Wexito11/Force-1-Hardato/README.md

# Форс-1 - робот-путеобходчик

Проект команды на Всероссийские соревнования по робототехнике «Хардатон «Инженерный вызов» 2026» (МГТУ им. Н.Э. Баумана).

Тема: «Разработка робототехнических систем для автономной инспекции и обслуживания протяжённой критической инфраструктуры». Направление - железная дорога.

## Идея

Автономный робот едет по рельсам и проверяет путь: ширину колеи, перекос, износ головки рельса, стыки и шпалы. Робот состоит из двух модулей - каждый едет по своему рельсу - и двух телескопов между ними. Телескоп одновременно служит измерителем ширины колеи.

Режим укрытия: когда идёт поезд, робот сжимает телескопы, ложится на шпалы между рельсами, пропускает поезд над собой и снимает его ходовую часть снизу. Потом поднимается и возвращается на рельсы.

Обслуживание: маркировка найденных дефектов, уборка металлического мусора электромагнитом, подтяжка ослабших болтов (проба на финале), концепт сварочной головки.

Масштаб прототипа 1:2: колея 760 мм (решение 08.11; версия 1:8 - запасная).

## Сроки

| Этап | Даты |
|---|---|
| Заочный этап (паспорт, 3D-модель, схема) | 02.11 - 08.11.2026, цель - всё готово к 06.11 |
| Финал (прототип и защита) | 27.11 - 01.12.2026, Роботоцентр МГТУ |

## Структура репозитория

| Папка | Что внутри | Ответственный |
|---|---|---|
| `docs/` | ТЗ и габариты, концепция, план работ, паспорт | вся команда |
| `cad/` | STEP, STL, DXF, рендеры 1:2, чертежи PDF, `tools/` - исходники генератора и рендерер | Участник 1 (модули), Участник 2 (телескоп, сборка) |
| `electronics/` | принципиальная схема, распиновка, таблица компонентов .xls | Участник 3 |
| `firmware/esp32_a/` | прошивка модуля A: мотор, полозья, ремонт, TOF, HC-SR04 - заготовка | финал |
| `firmware/esp32_b/` | прошивка модуля B: мотор, полозья, телескоп, AS5600, RFID - заготовка | финал |
| `firmware/rpi/` | `force1.py` - состояния S0-S11, отчёт, веб-панель; `rail_vision.py` - камера (в track/) | финал |
| `track/test-rail-1k2/` | тест-рейка 1:2 с дефектами: чертёж, DXF, rail_vision.py | Участник 4 |
| `edu/` | «Форс-1 Junior» - учебная версия и инструкция для школьников | Участник 4 |

## Правила

- Каждый работает в своей папке.
- Коммит в конце каждого дня с понятным сообщением: что сделано.
- Исходники CAD тяжёлые - храним на общем диске, в git кладём экспорт (STEP, PDF, PNG).
- Перед началом CAD сверяться с `docs/tz-gabarity.md`. Если число меняется - сначала правим этот файл и пишем в чат команды.

## Документы

- [ТЗ и габариты](docs/tz-gabarity.md)
- [Концепция (PDF)](docs/concept.pdf)
- [План работ (PDF)](docs/plan.pdf)
- [Общий контекст для агентов](docs/context.md)
- [Промпты для агентов](docs/agent-prompts.md)
- [Сверка перед сдачей](docs/sverka-sdacha.md)
- [Как собрать (финал)](docs/sborka.md)
- [Карта проекта: что где лежит](docs/karta-proekta.md)
- [Защита на финале: 5 минут](docs/zashchita.md)
- [Протокол Pi ↔ ESP32](firmware/PROTOCOL.md)
