Wexito11/Force-1-Hardato/electronics/README.md

# Электроника

Участник 3: принципиальная схема (силовые цепи толстыми линиями, сигнальные тонкими), распиновка ESP32 A, ESP32 B и Raspberry Pi 5, расчёт питания, таблица компонентов .xls.
