Wexito11/Force-1-Hardato/cad/README.md

# CAD

Экспорт STEP, рендеры (PNG, светлый фон) и чертежи деталей (PDF). Исходники CAD - на общем диске.

- Участник 1: модули A и B, колёса, полозья.
- Участник 2: телескоп и привод, общая сборка, рендеры, чертежи под лазер (раскладка 500×300, ≤ 3200 см² на материал).
