Wexito11/Force-1-Hardato/edu/README.md

# Форс-1 Junior

Учебная версия для школьников 7-11 классов: тележка на одном рельсе (Arduino Nano, JGA25-370, L298N, HW-511 считает шпалы, HC-SR04 - стоп перед препятствием, пищалка - сигнал дефекта). Инструкция: 5-6 шагов сборки, 2 урока по 45 минут, готовый скетч.
