Wexito11/Force-1-Hardato/firmware/esp32_a/README.md

# ESP32 A (модуль A)

Мотор + энкодер, 2 × MG996R полозьев, TOF250, HC-SR04 (TRIG IO12, ECHO IO36 через делитель), ремонтный модуль. Плата ESP32-ETH01. Связь с Raspberry Pi по UART2 (GPIO4/5), прошивка с Pi через EN/IO0 (GPIO17/27) или PL2303HX. Пишем на финале.
