Wexito11/Force-1-Hardato/firmware/esp32_b/README.md

# ESP32 B (модуль B)

Мотор + энкодер, 2 × MG996R полозьев, NEMA17 телескопа, AS5600 (ширина колеи), RFID, TOF250. Связь с Raspberry Pi по UART через телескоп. Пишем на финале.
