Wexito11/Force-1-Hardato/firmware/rpi/README.md

# Raspberry Pi 5

Камера (дефекты, осмотр поезда снизу), RPLIDAR C1, MPU-9250, логика инспекции и режима укрытия, веб-панель оператора по Wi-Fi.
