Wexito11/Force-1-Hardato/docs/tz-gabarity.md

# ТЗ и габариты

Черновик. Числа обсуждаем и фиксируем на созвоне во вторник 03.11. Пока этот файл не утверждён, CAD не начинаем.

## Габариты

| Параметр | Значение | Примечание |
|---|---|---|
| Масштаб / колея | ~1:8 / 190 мм | между внутренними гранями головок |
| Рельс демо-пути | головка ~12 мм, высота ~40 мм | фанера, склейка полос |
| Шпалы | 31 мм, шаг 68 мм | фанера с лазера |
| Модуль | 160 × 85 мм, высота корпуса ≤ 60 мм | колесо у внешнего края, корпус внутрь колеи; 2 этажа: фанера 6 мм + оргстекло 3 мм |
| Колесо | Ø50, реборда 5 мм, конус 1:20 | 3D-печать, ширина ~20 мм |
| Зазор между модулями на рельсах | ~30 мм | |
| Ход телескопа | ~35 мм | проверить в скелете CAD |
| «Дно вагона» на демо | лежащий робот + 20 мм | задаёт высоту доски-«поезда» |

## Что измеряем и как

| Параметр | Датчик, где стоит | Норма → дефект (демо) |
|---|---|---|
| Ширина колеи | AS5600 на шкиве телескопа, модуль B | 190 мм → отклонение > 2 мм |
| Перекос | MPU-9250, модуль A | 0° → крен > 0,8° |
| Износ головки | TOF250 вниз, по одному на модуль | эталон d0 → d - d0 > 2 мм (проверить точность датчика) |
| Стык | TOF250 + энкодер | провал > 3 мм длиной < 10 мм |
| Шпалы | HW-511 вниз, внутренняя сторона модуля | шаг 68 мм → отклонение > 10 мм или пропуск |
| Препятствие | RPLIDAR C1, модуль A, спереди | объект ближе 30 см → стоп |
| Координата | энкодер LM393 + RFID-метки | пикет каждые ~0,5 м |

## Компоновка

**Модуль A (ведущий):** Raspberry Pi 5, камера на MG90S, RPLIDAR C1, MPU-9250, ESP32 №1, L298N, мотор JGA25-370 + энкодер, TOF250, HW-511, 2 × MG996R, ремонтный модуль, зажим ремня.

**Модуль B (силовой):** держатель 4×18650, XH-M400 × 2, LM2596, тумблер, ESP32 №2, L298N, мотор + энкодер, NEMA17 + A4988 + шкив + AS5600, RFID, TOF250, 2 × MG996R.

Тяжёлое (батарея, моторы) - на нижний этаж. Размеры плат перед CAD берём из даташитов или замеряем.

## Питание

- 12 В (XH-M400) - моторы, NEMA17.
- 6 В (XH-M400) - сервоприводы. Полозья поднимать по очереди, чтобы снизить пиковый ток.
- 5,1 В - Raspberry Pi 5 (нужно 5 В 5 А): отдельный преобразователь, LM2596 не хватит.
- 5 В (LM2596) - ESP32 и датчики.
- Через телескоп в модуль A: 12 В, 6 В, 5 В, GND, UART.

## Вопросы организаторам

- [ ] Можно ли второй ESP32 (например, ESP32-C3-MINI из Приложения 2)?
- [ ] Модель Raspberry Pi в наборе и чем его питать?
- [ ] Выдаются ли аккумуляторы 18650?
- [ ] Есть ли пружины или резинки для телескопа?
- [ ] Материалы на демо-путь - из лимита команды или общие?
- [ ] Помпа и VL53L0X из Приложения 2 - можно ли?
- [ ] Какое передаточное число у JGA25-370 в наборе?
