Wexito11/Force-1-Hardato/track/README.md

# Демо-путь

Участник 4: рельсы и шпалы из фанеры, участки с дефектами (расширение колеи, перекос, зазор в стыке, пропуск шпалы, ослабший болт), доска-«вагон» на стойках.
