Wexito11/Force-1-Hardato/docs/context.md

# Контекст проекта «Форс-1» (Хардатон «Инженерный вызов» 2026)

Этот файл - общий контекст для всех чатов и агентов проекта. Читать первым. Если решение меняется - править здесь.

## Соревнование

- Организатор: Центр молодёжной робототехники МГТУ им. Н.Э. Баумана. Документы: «Регламент_Хардатон_2026.pdf», «Задание заочного этапа.pdf» (лежат в проекте).
- Тема: «Разработка робототехнических систем для автономной инспекции и обслуживания протяжённой критической инфраструктуры».
- Заочный этап: 02.11 - 08.11.2026, сдача до 08.11 23:59 МСК. Цель команды - всё готово к пятнице 06.11, отправка в субботу 07.11.
- Сдаём: паспорт проекта (PDF по шаблону), 3D-модель (3 изображения с разных ракурсов), электрическую принципиальную схему (силовые цепи толстыми линиями), чертежи деталей под ЧПУ в натуральную величину внутри прямоугольника 500×300 мм, таблицу компонентов .xls. Рендеры, схема и чертежи - одним PDF, всё в одной папке на диске, ссылка в паспорте.
- В финал проходят не более 10 команд. Финал: 27.11 - 01.12, очно, собрать рабочий прототип и защитить за 5 минут.
- Оценка заочного этапа (100 баллов): анализ аналогов 15, актуальность и новизна 14, соответствие теме 10, креативность 10, ГОСТ 7, развитие 7, качество 3D-сборки 10, графическая документация 10, электросхема 7, оптимальность 5, технологичность 5.

## Жёсткие ограничения

- В прототипе только компоненты и материалы организатора: базовый набор (Приложение 1 регламента), специальные (Приложение 2) - только по согласованию. Свои компоненты = дисквалификация. Свои - только ноутбуки и ПО.
- Листовые материалы (оргстекло 3/4 мм, фанера 3/4/6/10 мм): лазер 500×300 мм, не более 3200 см² каждого. Трубы алюминиевые Ø12/Ø10/Ø8/Ø6 ×1 мм - по 0,5 м. Профили Т, П, прямоугольный, Г - по 1 м. 3D-печать: поле 201×201×210 мм, не более 800 г с поддержками. Крепёж М3/М4, стойки, ремень GT2 1 м, шкивы Ø15, муфты 4 шт., колёса внедорожные 4 шт.
- Прототип должен быть безопасным (никакой настоящей сварки, огня и т.п.).

## Масштаб: 1:2 (решение 08.11)
Команда перешла с 1:8 на 1:2: в 1:8 робот в укрытии должен быть ниже 21 мм, это невозможно. Правило «правильно» (уточнено 09.11 по ГОСТ 9238): самые низкие части поезда - необрессоренные части тележек - не ниже 65 мм над УГР (новые конструкции - 80), ниже только гребни колёс. В 1:2: УГР 100 над шпалой, низ частей поезда 132,5, зона укрытия - высота ≤ 117 (запас 15) и |Y| ≤ 345 (внутри внутренних граней колёс поезда, запас 15). Путь 1:2 к Р65: колея 760 (по внутренним граням головок), головка 37,5, шаг шпал 272. Главный документ - «Масштаб 1:2 - решения», эталон файлов - `Хардатон\Участник 1\1к2`. Всё, что про колею 190 / трубы Ø10 / пружины-арки - устарело.

## Концепция
- Два модуля A (ведущий) и B (силовой), каждый на своём рельсе. Корпус 300 × 120 × 66, фанера 4 (шип-паз), крышка оргстекло 3. Колесо у внешнего края, корпус внутрь колеи.
- Колёса: по 2 на модуль - ведущее JGA25-370 при +X, холостое на M4. Обод Ø50 × 40, реборда Ø66 (с внутренней стороны), ширина 45, конус 1:20, база 240. 3D-печать.
- Телескоп: 2 направляющие (X = ±90, Z = 44) - П-профиль 20×20 L 440 в A, прямоугольный 15×10 L 440 в B на печатных вкладышах. Привод: Г-профиль 20×20 L 632 закреплён в A, на нём ремень GT2 зубьями наружу; в B NEMA17 вертикально, шкив Ø15 + прижимной ролик. Ход 80 на модуль (общий 160, зазор 502 → 342). Пружин нет: реборды прижимаются мотором с ограничением тока A4988, колею меряет AS5600 №1 на шкиве.
- Полозья: на модуль 2 × MG996R снаружи торцов, звенья 60, стойки 72,5, подошва фанера 6 (2 × 395 × 12). Поднят +50,8°, опущен -42,5° (колёса на 10 над рельсом). Момент ≤ 4,8 кг·см при массе ~3,2 кг.
- Режим укрытия: полозья вниз (A, потом B) → телескоп сжат → полозья вверх → робот лежит на шпалах (низ 12, крышка 81, лидар 113 над шпалой; части поезда не ниже 132,5), поезд проходит сверху, камера на MG90S снимает ходовую часть → обратно. Сигнал: команда по Wi-Fi или вибрация рельса (MPU-9250).

## Инспекция (пороги 1:2)
| Параметр | Датчик | Дефект |
|---|---|---|
| Ширина колеи | AS5600 №1 на шкиве телескопа | > 8 мм от 760 |
| Перекос | MPU-9250 (A) | крен > 0,8° |
| Износ головки | TOF250 вниз на каждом модуле | d - d0 > 8 мм |
| Стык | TOF250 + энкодер, камера (болты) | провал > 12 мм |
| Шпалы | HC-SR04 вниз через дно, по одному на модуль (HW-511 не достаёт) | 272 ± 40 или пропуск |
| Препятствие | RPLIDAR C1 на крышке A спереди (X 95,5), утоплен в вырез Ø58, площадка на стойках M3 на 58 от низа корпуса; верх 101 от низа корпуса, в укрытии 113 < 117 | ближе 30 см → стоп |
| Координата | энкодер LM393 + RFID RC522 (метки на внешней грани головки); запас - счёт шпал | пикеты |

Оператор: веб-страница на Raspberry Pi 5 - график колеи и список дефектов «тип + координата + фото». Состояния S0-S11 - в документе «Демо-путь и ремонт».

## Обслуживание (ремонт)
- В прототип: маркировка каплей краски (помпа из Прил. 2 + LR7843 №1; запас - магазин фишек на MG90S), уборка металлического мусора (электромагнит BR-P25/11 на рычаге MG90S + LR7843 №2, ШИМ ≤ 70 %).
- Проба на финале: гайковёрт - JGA25-370 №3 (лучше JGA 77 об/мин из Прил. 2), печатная головка под ключ 7 на пружине, рычаг MG90S, стоп по AS5600 №2 + концевик. Для М4 в фанере момента хватает (~0,25 Н·м), для реального пути - нет («развитие»).
- Только концепт в CAD: сварка/наплавка стыков.

## Электроника
- Модуль A: Raspberry Pi 5 (вертикально на наружной стенке), камера Pi на MG90S под крышкой, RPLIDAR C1 на крышке A спереди, утоплен в вырез Ø58 (луч ~177 над шпалой на рельсах = 77 над головкой, обзор 360°; в укрытии верх 113 < 117), MPU-9250, ESP32-ETH01 = ESP A (UART2 к Pi GPIO4/5, прошивка с Pi через EN/IO0), PCA9685 (5 серво + ключи), L298N (ход A + гайковёрт), XH-M400 ×2 (6,0 В серво/помпа; 5,1 В Pi 5), LR7843 ×2, TOF250, HC-SR04, 2 × MG996R, ремонтный модуль, колодка ремня.
- Модуль B: 4×18650 2×2 + предохранитель + тумблер + XFW-001, LM2596 (5,0 В ESP B), ESP32 B (UART0 к Pi через телескоп), L298N (ход B), NEMA17 + A4988 + шкив + AS5600 №1, RC522, TOF250, HC-SR04, 2 × MG996R (пины 14/15).
- Питание: моторы, A4988 и магнит - от VBAT (12-16,8 В), ШИМ моторов ≤ 80 %. Все датчики на 3,3 В; echo HC-SR04 через делитель. ~35 Вт, ~0,85 ч.
- Жгут W1 вдоль телескопа: VBAT ×2, GND ×2, +6V, TX, RX (7 жил), петля запаса ≥ 200 мм.
- Распиновка - в документе «Электроника - решения» (+ HC-SR04: ESP A (ETH01) TRIG IO12 / ECHO IO36, ESP B TRIG 2 / ECHO 35; концевик - ESP A IO2; эталон - лист 2 xls).

## Материалы 1:2
Фанера 4 - 1672 см², оргстекло 3 - 706, фанера 6 - 220 (полозья) + шпалы демо-пути ~2100, фанера 10 - рельсы демо-пути ~2900. Профили: П 880, прямоугольный 880, Г 632 (все из 1 м) - «вагон» делать из Т-профиля и фанеры 6. Пластик ≈ 400 г из 800.

## Учебное применение

«Форс-1 Junior»: тележка на одном рельсе для школьников 7-11 классов (Arduino Nano, JGA25-370, L298N, HW-511 считает шпалы, HC-SR04 - стоп, пищалка - дефект). Для заочного этапа - 1 страница в паспорте.

## Команда и роли (4 человека + Claude)
Капитан - Уэкслер; У1 Марьям - модули, компоновка, перевод в 1:2; У2 Полина - телескоп и сборка; У3 Илья - электроника; У4 - логика, ремонт, путь (капитан).

- Участник 1 - модули: скелет CAD, корпуса, колёса, полозья.
- Участник 2 - телескоп и привод (по интерфейсному листу), общая сборка, рендеры, чертежи под лазер.
- Участник 3 - электроника: схема, распиновка, питание, таблица .xls.
- Участник 4 - логика инспекции, ремонтный модуль, демо-путь, Junior.
- Claude - паспорт: аналоги, актуальность, принцип работы, развитие, ГОСТ, итоговый PDF.

## Статус 09.11
Сдано: основной PDF 1:2, xls, паспорт. Сделано к финалу: пороги 1:2 в блок-схеме, 9 STL мелких деталей (`Участник 1\1к2\3D\STL\Мелкие детали`), заготовки прошивок (`Хардатон\Прошивки`), черновик презентации, письмо организаторам. Осталось: демо-путь 1:2, HC-SR04 в Э3 (пока - извещение № 1), сверка мелких деталей по реальным платам, прошивки на железе. Эталон пинов - лист 2 xls (ESP A = ETH01). См. «Сверка перед сдачей» и «Сборка».

## График

- Вт 03.11 - вся команда: габариты, что меряем, компоновка, вопросы организаторам.
- Ср 04.11 - скелет CAD, интерфейсы телескопа, черновик схемы, логика инспекции.
- Чт 05.11 - детали модулей, телескоп, чистовая схема и xls, ремонтный модуль и путь.
- Пт 06.11 - общая сборка, рендеры, чертежи под лазер, сверка, паспорт.
- Сб 07.11 - проверка и отправка. Вс 08.11 - резерв.

## Открытые вопросы к организаторам

Второй ESP32 (ESP32-C3-MINI?), модель Raspberry Pi и питание, аккумуляторы 18650, пружины, материалы на демо-путь, помпа и VL53L0X из Прил. 2, передаточное число JGA25-370.

## Репозиторий

https://github.com/Wexito11/Force-1-Hardato - структура: docs/, cad/, electronics/, firmware/{esp32_a,esp32_b,rpi}/, track/, edu/. Числа габаритов - в docs/tz-gabarity.md.

## Стиль текстов

Русский язык, обычный дефис «-» вместо длинного тире.
