Wexito11/Force-1-Hardato/docs/sborka.md

# Как собрать «Форс-1» (масштаб 1:2)

Инструкция для финала 27.11 - 01.12. Порядок подобран так, чтобы долгие операции (печать колёс) шли параллельно с остальным, а каждый узел проверялся до того, как его закроют крышкой. Числа - из документа «Масштаб 1:2» (Участник 1); если там что-то поменяется, менять и здесь.

## 0. Перед началом (день 1, утро)

1. Сверить выданный набор с `Форс-1_компоненты.xls`. Особо: 2 диаметральных магнита для AS5600, 4 аккумулятора 18650, второй ESP32 (если нет - ESP32-ETH01 в модуль A), шлейф камеры Pi 5, помпа.
2. Зарядить 18650. Собрать батарею 4S в держателе 2×2, измерить 14,8-16,8 В, поставить предохранитель и тумблер. Батарея пока ни к чему не подключается.
3. Запустить печать (раздел 1) и лазер (раздел 2) сразу - это самые долгие этапы.
4. Прошить ESP32 A и B тестовыми скетчами (мотор, серво, датчики по одному) - ещё до сборки, на столе.

## 1. Что напечатать (в порядке запуска)

| Очередь | Деталь | Шт. | Пластик | Заполнение | Примечание |
|---|---|---|---|---|---|
| 1 | Колесо: обод Ø50 × 40, реборда Ø66 × 5, ширина 45, конус 1:20 | 4 | PLA/PETG | 20-30 % | ~96 см³ каждое; 2 со ступицей под D-вал JGA25 (ведущие), 2 с отверстием под ось M4 (холостые). Печатать ребордой вниз. |
| 2 | Вкладыши телескопа (прямоугольный 15×10 внутри П 20×20) | 4 | PETG | 100 % | скользящая посадка, после печати прогнать профиль, при туге - шкурка |
| 2 | Прижимной ролик ремня + ось | 1 | PETG | 100 % | прижимает GT2 к шкиву Ø15 |
| 3 | Кронштейн MG996R на торец корпуса | 4 | PETG | 50 % | 4 × M3 |
| 3 | Наконечники звеньев полозьев (труба Ø6, звено 60 мм) | 8 | PETG | 100 % | |
| 3 | Стойки полозьев 72,5 + крепление подошвы | 4 | PETG | 50 % | |
| 4 | Кронштейн TOF250 (наружная стенка, над головкой) | 2 | PLA | 30 % | |
| 4 | Кронштейн HC-SR04 вниз через дно | 2 | PLA | 30 % | |
| 4 | Площадка лидара 58×58×2 (или фанера 4) на 4 стойках M3×54 от дна A, кронштейн камеры на MG90S | 1 + 1 | PLA | 30 % | лидар на крышке A спереди, головка через вырез Ø58 |
| 5 | Ремонтный модуль: головка под ключ 7, 2 рычага, магазин, заслонка, 8 фишек, сопло, кронштейн магнита | компл. | PETG | 100 % | ~51 г, STL есть (`Участник 4\3D\STL печать`) |
| 6 | Держатель шкива с магнитом AS5600, колодка ремня, крепления профилей | компл. | PETG | 100 % | |

Итого ≈ 400 г из 800. STL мелких деталей (очереди 2-4, 6) - в `cad/stl/small/`, генератор `cad/tools/small_parts.py`; перед печатью сверить размеры посадочных мест с реальными платами и серво из набора.

## 2. Что вырезать на лазере

| Материал | Детали | Площадь | Файл |
|---|---|---|---|
| Фанера 4 | стенки и дно модулей A и B (шип-паз 5 × 13,2), с отверстиями под датчики, серво, профили | 1672 см² | `Участник 1\1к2\Лазер DXF` |
| Оргстекло 3 | крышки A и B (окно камеры, лидар, XFW-001, тумблер) | 706 см² | там же |
| Фанера 6 | подошвы полозьев 2 × 395 × 12, стойки и опоры «вагона» | 220 + ~300 см² | там же + У4 |
| Фанера 10 | рельсы демо-пути (1 м): шейка 10, подошва 75, головка 37,5 | ~2900 см² | У4, сделать |
| Фанера 6 | шпалы 4 × 875 × 60 (из двух половин по 440) | ~2100 см² | У4, сделать |

Профили отрезать: П 20×20 - 2 × 440; прямоугольный 15×10 - 2 × 440; Г 20×20 - 1 × 632; Т 30×20 - перекладина «вагона» ~900. Трубы Ø6 - 8 звеньев по 60 (минус наконечники).

## 3. Порядок сборки

### Шаг 1. Корпуса (день 1)
1. Собрать корпуса A и B насухо на шипах, проверить прямоугольность, затем проклеить. Крышки не ставить.
2. Разметить и поставить стойки M3 под платы по листу `ФОРС1_Компоновка_модулей.pdf`. Тяжёлое вниз.

### Шаг 2. Колёса и моторы (день 1)
1. В каждом модуле ведущее колесо при +X: JGA25-370 в кронштейн, колесо на D-вал, винт стопорный. Холостое колесо на оси M4 с шайбами по бокам, гайка с фиксатором.
2. Реборда - **с внутренней стороны колеи**, конус наружу. Колесо крутится свободно, биение ≤ 0,5 мм.
3. Энкодер LM393 с диском на валу ведущего мотора.

### Шаг 3. Телескоп (день 1-2)
1. В модуле A закрепить 2 × П-профиль 20×20 (X = ±90, Z = 44), в модуле B - 2 × прямоугольный 15×10 с печатными вкладышами. Вставить, проверить ход 160 мм без заеданий; при туге - шкурка по вкладышам, не по профилю.
2. На Г-профиль 632 приклеить ремень GT2 зубьями наружу на длине 190 мм (цианакрилат, прижать на 10 мин). Закрепить Г-профиль в A (X = 0, Z 42…62).
3. В модуле B поставить NEMA17 вертикально (вал вверх), шкив Ø15 на вал, прижимной ролик напротив. Магнит AS5600 в торец шкива, датчик над ним на 1-2 мм.
4. Проверка: вращать шкив рукой - модули сходятся и расходятся на весь ход, ремень не проскакивает, AS5600 считает.

### Шаг 4. Полозья (день 2)
1. На торцы корпусов снаружи - кронштейны с MG996R (X = ±161, Z = 20). Звенья 60 мм из трубы Ø6 с наконечниками, один шарнир в пазу 20 мм.
2. Стойки 72,5 + подошвы из фанеры 6. Серво одного модуля вращаются **навстречу**.
3. Выставить серво: поднято +50,8° (низ подошвы на 12 ниже корпуса), опущено -42,5° (колёса на 10 над рельсом). Записать значения в прошивку, поставить механические ограничители.
4. Проверка под нагрузкой: модуль с батареей поднимается на столе, серво не гудит дольше 1 с.

### Шаг 5. Электроника модуля B (день 2)
Держатель 18650 2×2, XFW-001 и тумблер в крышку, LM2596 (5,0 В), ESP32 B, L298N (ход B), A4988 + NEMA17, AS5600 №1, RC522 у наружной стенки, TOF250 на кронштейне наружной стенки (над головкой рельса), HC-SR04 вниз через дно, 2 × MG996R на PCA? - нет, серво B на пины 14/15 ESP B.
**Перед подачей питания:** выставить LM2596 на 5,0 В без нагрузки, проверить полярность на каждой плате.

### Шаг 6. Электроника модуля A (день 2-3)
Raspberry Pi 5 вертикально на наружной стенке, XH-M400 №1 = 6,0 В (серво, помпа), XH-M400 №2 = 5,1 В (Pi 5) - выставить без нагрузки! ESP32-ETH01 = ESP A (UART2 к Pi GPIO4/5, EN/IO0 ← Pi GPIO17/27), PCA9685 (CH0-1 MG996R A, CH2 камера, CH3 магнит, CH4 гайковёрт, CH5 фишки, CH8-10 гайковёрт L298N, CH11 помпа, CH12 магнит), L298N (ход A + гайковёрт), 2 × LR7843, MPU-9250, TOF250, HC-SR04, концевик гайковёрта на IO2 (ETH01), HC-SR04 A: TRIG IO12, ECHO IO36 через делитель.
Лидар RPLIDAR C1 на площадке на 4 стойках M3 (58 от дна) в передней части A (X 95,5), головка выходит через вырез Ø58 в крышке; верх 101 от низа корпуса. Ставить до крышки, крышку надевать сверху. Камера под крышкой, объектив вверх через оргстекло, на MG90S.
Ремонтный модуль под дном A: сопло, рычаг магнита, гайковёрт на JGA25-370 №3 (или JGA 77 об/мин), AS5600 №2 на головке.

### Шаг 7. Жгут W1 через телескоп (день 3)
7 жил: VBAT ×2, GND ×2, +6V, TX, RX. Вдоль П-профиля, петля запаса **≥ 200 мм** (ход 160). Разъём на стороне B, чтобы модули разъединялись.

### Шаг 8. Первое включение (день 3)
1. Без моторов: тумблер → XFW-001 показывает VBAT, ток < 0,5 А. Измерить 6,0 / 5,1 / 5,0 В на шинах.
2. Подключить Pi 5 и ESP, проверить связь: Pi ↔ ESP A по UART2 (GPIO4/5), Pi ↔ ESP B по UART (GPIO14/15).
3. Датчики по одному: TOF250 (расстояние до стола), HC-SR04, MPU-9250 (крен), AS5600 ×2 (угол меняется), RC522 (метка), энкодеры, лидар (точки на экране), камера (кадр).
4. Приводы по одному, робот **на подставке, колёса в воздухе**: моторы хода (направление!), серво полозьев (углы из шага 4), NEMA17 (ход в обе стороны, стоп по AS5600), ремонтный модуль.

### Шаг 9. Демо-путь и «вагон» (параллельно, день 2-3)
Рельсы фанера 10, шпалы фанера 6 с шагом 272, колея 760 по внутренним граням головок. Дефекты: уширение 8-10 мм на втором полуметре, подкладка 6 мм под рельс (перекос), вырез 8 мм в головке (износ), стык с накладками и болт M4, гайка M3 на шпале (мусор), убрать одну шпалу. RFID-метки на 0 и ~500 мм на внешней грани головки. «Вагон»: Т-профиль на двух стойках из фанеры 6, низ на 132 мм над шпалой (необрессоренные части поезда 1:2: УГР 100 + 65/2), внутренняя ширина 720.

### Шаг 10. Испытания на пути (день 3-4)
1. Поставить робота на рельсы, A4988 отключить - пружин нет, поэтому реборды прижимаются **мотором с ограничением тока** A4988, затем AS5600 обнуляется = колея 760.
2. Калибровка d0 (TOF250 до головки) на ровном участке.
3. Прогон: каждый дефект должен появиться в отчёте с координатой. Пороги 1:2: колея > 8 мм, крен > 0,8°, износ > 8 мм, стык > 12 мм, шпалы 272 ± 40, препятствие < 30 см.
4. Укрытие: полозья вниз (сначала A, потом B), телескоп сжать до 342, полозья вверх, провести «вагон» (низ 132 над шпалой = необрессоренные части 1:2), обратно. Засечь время - для 5-минутной защиты.
5. Ремонт: краска/фишка на дефект, магнит снимает гайку, гайковёрт на болте стыка.

### Шаг 11. Защита
Презентация `Презентация_«Форс-1».pdf` на флешке, прогон демо 2 раза, запасной сценарий без лидара (HC-SR04 вперёд) и без RFID (счёт шпал).

## 4. Типовые проблемы

| Симптом | Причина | Что делать |
|---|---|---|
| Телескоп заедает | вкладыши туго | шкурка по вкладышу; не по профилю |
| Ремень проскакивает | слабый прижим ролика | подложить шайбу под ось ролика |
| Серво полозьев гудит и не держит | рычаг длиннее 60 или масса > 3,2 кг | взвесить; укоротить звено; 6,0 В под нагрузкой проверить |
| Pi 5 перезагружается | U2 ниже 5,0 В под нагрузкой | выставить 5,1 В, провода толще, короче |
| HC-SR04 не видит шпалу | echo 5 В без делителя / расстояние > 85 мм | делитель 1k/2k; порог по расстоянию, не по наличию |
| AS5600 выдаёт мусор | магнит не диаметральный / зазор > 2 мм | проверить магнит, зазор 0,5-1,5 мм |
| Электромагнит греется | 16,8 В на 12 В катушку | ШИМ ≤ 70 %, включать только на проходе |
| RC522 не читает | > 45 мм до метки | метку ближе к стенке B или счёт шпал |
