Wexito11/Force-1-Hardato/docs/karta-proekta.md

# Карта проекта «Форс-1»: что есть, где лежит и зачем

Обновлено 09.11.2026. Три места хранения: папка на компьютере `E:\Users\wexle\Documents\Хардатон`, проект «Хардатон» в Claude и репозиторий `github.com/Wexito11/Force-1-Hardato`.

## 1. Одной строкой

Робот-путеобходчик 1:2 (колея 760): два модуля A и B на своих рельсах, соединены телескопом из профилей с ремённым приводом, прячутся между рельсами под поездом. Инспектирует колею, перекос, износ, стыки, шпалы; маркирует дефекты, убирает мусор, подтягивает болт.

## 2. Файлы для сдачи (папка на диске)

| Файл | Что это | Автор |
|---|---|---|
| `ФОРС1_1к2_3D_схема_чертежи.pdf` (17 стр.) | **основной**: рендеры 1:2, Э3 + ПЭ3, габаритные схемы ГЧ1/ГЧ2, чертежи под лазер, тест-рейка, извещение № 1 | У1, У3, У4, Claude |
| `Форс-1_компоненты.xls` | таблица компонентов, распиновка, питание, жгут | У3 |
| Паспорт проекта (PDF по шаблону) | текст в документе проекта «Паспорт проекта - текст» | Claude + капитан |
| `Запасной комплект 1-8\ФОРС1_3D_схема_чертежи.pdf` (21 стр.) | первая версия в 1:8 (колея 190) - не смешивать с основной | У1 |

## 3. Папка `Хардатон` на компьютере

```
Хардатон\
  ФОРС1_1к2_3D_схема_чертежи.pdf   основной PDF (1:2)
  ФОРС1_3D_схема_чертежи.pdf       запасной (1:8)
  ФОРС1_Схема_алгоритма.pdf        блок-схемы ГОСТ 19.701, состояния S0-S11, пороги 1:2
  ФОРС1_Чертежи_демо-пути.pdf      демо-путь 1:8 (к финалу переделать на 1:2)
  Презентация_Форс-1_черновик.pptx черновик слайдов к защите (9 шт.)
  Письмо_организаторам.md          15 вопросов к организаторам
  Прошивки\                        заготовки ESP A, ESP B, Raspberry Pi + протокол
  Форс-1_схема_Э3.pdf              принципиальная схема, 2 листа + ПЭ3
  Форс-1_монтажная_схема.pdf       наглядная схема для пайки
  Форс-1_компоненты.xls            таблица компонентов
  Участник 1\
    1к2\                           ЭТАЛОН: модули, колёса, полозья, телескоп 1:2, DXF, STEP, рендеры
    1к2\3D\STL\Мелкие детали\      9 печатных кронштейнов (small_parts.py)
    Лазер DXF\                     1:8 (устарело)
    ФОРС1_Компоновка_модулей.pdf   где какая плата стоит
  Участник 2\                      телескоп 1:8 на трубах - устарел; из него живы только методика и скрипты
    Форс-1_Участник2.zip           исходники Python (params.py, drawings_u2.py)
  Участник 4\
    3D\                            STEP: демо-путь 1:8, ремонтный модуль, концепт сварки
    3D\STL печать\                 STL ремонтного модуля - актуально
    Лазер DXF\                     путь 1:8 (устарело)
    Форс-1_Участник4.zip           исходники (track.py)
```

## 4. Документы проекта в Claude (папка «Хардатон» → файлы)

| Документ | Зачем | Актуален? |
|---|---|---|
| Контекст Форс-1 | общий контекст для любого чата | да, обновлён на 1:2 |
| Масштаб 1:2 - решения | **главный документ по конструкции**: все числа 1:2 | да (лидар перенесён 09.11 - см. Сверка, п. L) |
| Модули - решения | полозья, компоновка, печать (сделано в 1:8, перенесено в 1:2) | частично, числа - из «Масштаб 1:2» |
| Телескоп и сборка - решения | телескоп на трубах Ø10 | нет, заменён профилями |
| Электроника - решения | питание, распиновка, жгут | да, кроме HW-511 → HC-SR04 |
| Демо-путь и ремонт | логика S0-S11, ремонтный модуль, путь, Junior + скетч | логика и ремонт - да; путь и пороги - 1:8 |
| Участник 4 - заявка и замены | три уровня сборки, список на согласование, замены | да |
| Паспорт проекта - текст | полный текст паспорта с источниками [1]-[13] | да, заполнить фамилии и ссылку |
| Промпты для агентов | 5 промптов по ролям | да |
| Сверка перед сдачей | что не сходится и что чинить | да |
| Сборка | как собрать на финале | да |
| Карта проекта | этот документ | да |

## 5. Репозиторий `Force-1-Hardato`

```
README.md              о проекте, роли, правила
docs/
  context.md           общий контекст (= документ «Контекст Форс-1»)
  tz-gabarity.md       ТЗ и габариты (1:8 - исторический; актуальные числа в context.md)
  concept.pdf          первая концепция с рисунками (1:8)
  plan.pdf             план недели заочного этапа
  uchastnik-4.pdf      задачи участника 4 с рисунками
  agent-prompts.md     промпты агентов
  sverka-sdacha.md     сверка перед сдачей
  sborka.md            инструкция по сборке
  karta-proekta.md     этот файл
  zashchita.md         сценарий защиты на 5 минут
  Презентация_Форс-1_черновик.pptx  черновик слайдов (9 шт.) под сценарий
  pismo-organizatoram.md  вопросы организаторам, 15 пунктов
  ФОРС1_Схема_алгоритма.pdf  блок-схемы ГОСТ 19.701, пороги 1:2
  sdacha/              то, что сдано: основной PDF (17 стр.) и xls
  ФОРС1_Схема_алгоритма.pdf
cad/
  step/ stl/ dxf/      экспорт 1:2 (робот на рельсах, укрытие, колёса, лазер); stl/small/ - 9 мелких печатных деталей (tools/small_parts.py)
  renders/             рендеры 1:2 (z-буфер), tools/zrender.py - рендерер, остальное - генератор модели (cadquery)
  *.pdf                габаритная схема, чертежи лазер
electronics/           Э3, монтажная схема, xls, извещение № 1
track/test-rail-1k2/   тест-рейка 1:2: PDF, DXF, rail_vision.py (камера), testrail.py
firmware/
  PROTOCOL.md          протокол Pi <-> ESP A/B (текстовые команды, телеметрия 10 Гц)
  esp32_a/esp32_a.ino  заготовка прошивки A (мотор, полозья, ремонт, TOF, HC-SR04, AS5600 №2)
  esp32_b/esp32_b.ino  заготовка прошивки B (мотор, полозья, NEMA17, AS5600 №1, RFID, TOF, HC-SR04)
  rpi/force1.py        состояния S0-S11, пороги 1:2, defects.csv, веб-панель :8080, режим --sim
```

Экспорт из папки `Хардатон` скопирован 09.11. Прошивки - заготовки: компилируются по смыслу, но на железе не проверялись; пины и углы серво подбирать на сборке.

## 6. Ключевые числа 1:2 (чтобы не искать)

| Что | Значение |
|---|---|
| Колея / головка / УГР над шпалой | 760 / 37,5 / 100 |
| Шпала / шаг | 1375 (демо ≥ 875) / 272 |
| Зона укрытия | ширина по колёсам поезда |Y| ≤ 345, верх ≤ 117 над шпалой (ГОСТ 9238: 65 мм над УГР / 2 - запас 15) |
| Корпус модуля | 300 × 120 × 66, фанера 4, крышка оргстекло 3 |
| Колесо | обод Ø50 × 40, реборда Ø66, ширина 45, база 240 |
| Телескоп | П 20×20 (A) + прямоугольный 15×10 (B), 2 шт. × 440, ход 80 на модуль |
| Привод телескопа | Г-профиль 632 с ремнём GT2 в A, NEMA17 + шкив Ø15 + ролик в B, AS5600 №1 |
| Полозья | 2 × MG996R на модуль, звенья 60, подошва фанера 6; +50,8° / -42,5° |
| Робот в укрытии | низ 12, корпус 81, лидар 113 над шпалой |
| Масса | ~3,2 кг |
| Питание | VBAT 14,8-16,8 (моторы, A4988, магнит), 6,0 В серво, 5,1 В Pi 5, 5,0 В ESP B |
| Пороги | колея > 8 мм, крен > 0,8°, износ > 8 мм, стык > 12 мм, шпалы 272 ± 40, препятствие < 30 см |

## 7. Команда

| Кто | Роль | Что сделал |
|---|---|---|
| Уэкслер (капитан) | координация, логика, ремонт, путь, документы | контекст, план, паспорт, сдача |
| Марьям (У1) | модули, полозья, компоновка, перевод в 1:2 | основной PDF 1:2 |
| Полина (У2) | телескоп, привод, сборка | методика и первая версия телескопа |
| Илья (У3) | электроника | Э3, монтажная, xls |

## 8. Открытые вопросы организаторам

Второй ESP32-WROOM, аккумуляторы 18650, помпа и краска, предохранитель 7,5 А, шлейф CSI для Pi 5, JGA 77 об/мин, MX1508 для Junior, RFID-метки (2-4), обратный диод на магнит, входит ли демо-путь в лимиты материалов, магниты к AS5600.
