Wexito11/Force-1-Hardato/docs/sverka-sdacha.md

# Сверка перед сдачей (08.11.2026, 23:00)

Проверены документы всех четырёх участников и паспорт. Основная версия - **масштаб 1:2** (решение Участника 1 от 08.11). Ниже - что не сходится и что сделать. Сначала то, что успеть до 23:59, потом то, что чинить к финалу.

## 1. Сделать до 23:59 (сдача)

| # | Что | Где | Действие |
|---|---|---|---|
| 1 | Папка сдачи - только 1:2 | диск | В корне: `ФОРС1_1к2_3D_схема_чертежи.pdf`, `Форс-1_компоненты.xls`, паспорт PDF. Файлы 1:8 (`ФОРС1_3D_схема_чертежи.pdf`, `ФОРС1_Чертежи_демо-пути.pdf`, DXF 1:8) - в подпапку `Запасной комплект 1-8`, чтобы эксперт не смешал две колеи (190 и 760). |
| 2 | Паспорт: пустые поля | паспорт | Фамилии и отчества Марьям, Полины, Ильи; ссылка на папку диска в разделе «Техническая документация»; фото. Без ссылки документация не засчитается. |
| 3 | Таблица компонентов .xls | Участник 3 | Трубы Ø10/Ø12 убрать. Добавить: П-профиль 20×20 - 880 мм, прямоугольный 15×10 - 880 мм, Г-профиль 20×20 - 632 мм, шкив Ø15 + прижимной ролик. HW-511 ×2 в роботе заменить на HC-SR04 ×2 (+1 Junior = 3 из 4), HW-511 остаётся только в Junior. Добавить 2 делителя (резисторы 1k/2k) на echo. Пружины - убрать (их нет). |
| 4 | Схема Э3: HW-511 → HC-SR04 | Участник 3 | Если схема в редакторе и есть 10 минут: заменить символ HW-511 на HC-SR04 (TRIG - выход, ECHO - через делитель на вход 35). Если времени нет - оставить, в xls в колонке «примечание» написать «на 1:2 заменён на HC-SR04», поправить к финалу. |
| 5 | Паспорт ↔ PDF: одни числа | паспорт | Проверить, что в паспорте и в PDF одинаково: колея 760, корпус 300×120×66, колесо Ø50/реборда Ø66, ход телескопа 80 на модуль, порогов 1:2 (колея > 8 мм, износ > 8 мм, стык > 12 мм, шпалы 272 ± 40). |
| 6 | Отправка | форма | Ссылка на папку с открытым доступом «по ссылке», проверить с другого аккаунта, что папка открывается. |

## 2. Что не сходится (чинить к финалу, в сдачу не влияет)

| # | Конфликт | Кто | Решение |
|---|---|---|---|
| A | **Профили заняты дважды.** Телескоп 1:2 берёт прямоугольный 15×10 - 880 мм и Г 20×20 - 632 мм. «Вагон» Участника 4 (1:8) брал прямоугольный 760 мм и Г 800 мм. В наборе по 1 м каждого. | У4 | «Вагон» 1:2 делать без этих профилей: перекладина из Т-профиля 30×20 (1 м, не занят), стойки и опоры из фанеры 6 (остаток ~880 см²). |
| B | **Демо-путь 1:2 не спроектирован.** Есть только числа (колея 760, рельс 100, шпалы ≥ 875 с шагом 272). Чертежи пути - 1:8. | У4 | Рельсы - фанера 10 (1 м пути ≈ 2900 см² из 3200, фанера 10 больше нигде не нужна). Шпалы - фанера 6 (4 шт. × 875 × 60 ≈ 2100 см²; остаток после полозьев 2980). Длина пути 1 м, 4 шпалы. Спросить организаторов, входит ли путь в лимиты. |
| C | Пороги в блок-схеме алгоритма - обновлены на 1:2 (09.11), `docs/ФОРС1_Схема_алгоритма.pdf`. | У4 | сделано |
| D | **Жгут W1.** У2 считал петлю 50 мм под ход 37 мм. На 1:2 ход 160 мм. | У3 | Петля запаса ≥ 200 мм, жгут вдоль П-профиля, не внутри трубы (труб больше нет). |
| E | **HW-511 не достаёт до шпалы** на 1:2 (85 мм). | У3, У4 | Счёт шпал - HC-SR04 вниз через дно, по одному на модуль. Пины (как в xls и прошивке): ESP A (ETH01) TRIG IO12, ECHO IO36 (делитель); ESP B TRIG 2, ECHO 35 (делитель). Концевик гайковёрта - ESP A IO2. |
| F | **RFID на 1:2** - метка на внешней грани головки, до RC522 ~45 мм. Дальность RC522 ~30-50 мм, на пределе. | У4 | Запасной вариант уже есть: координата = номер шпалы × 272 + энкодер. Проверить дальность на первом тесте. |
| G | **Печатные детали**: STL сделаны 09.11 (`cad/stl/small/`, генератор `cad/tools/small_parts.py`): кронштейн MG996R, наконечник звена, вкладыш телескопа, площадка лидара, кронштейн TOF250, стойка HC-SR04, ролик и колодка ремня, держатель AS5600. Размеры плат TOF250 и шаг отверстий C1 - сверить с реальными деталями на финале, поправить параметры вверху скрипта. | У1, У2 | сделано, сверить размеры |
| H | **Документ Участника 2 устарел** (трубы Ø10, пружины-арки, корпус 66×200×80). | У2 | Не использовать. Актуальный телескоп - в документе «Масштаб 1:2». |
| I | **Модель КОМПАС «хакатон_широкий»** - колея 390, тоже устарела. | У1 | Эталон - `Участник 1\1к2`. |
| J | Магниты AS5600 (диаметральные Ø6×2,5) - нужны 2 шт. | капитан | Проверить при получении набора. |
| L | **Зона укрытия пересчитана по ГОСТ 9238** (09.11): низ необрессоренных частей поезда 65 мм над УГР → в 1:2 потолок 117 над шпалой (было 85). **Лидар перенесён на крышку A спереди** (X 95,5), утоплен в вырез Ø58, площадка на 4 стойках M3 от дна (отверстия в дне A-5 и крышке A-6 - DXF обновлены). Верх в укрытии 113. Площадка - печать или фанера 4 из остатка. | У1 | сделано в модели, PDF, DXF, STEP, ГЧ1, ГЧ2 |
| K | Второй ESP32-WROOM - по согласованию; запас - ESP32-ETH01 в модуле A. | капитан | Вопрос организаторам уже задан. |

## 3. Что сходится (проверено)

- Моторы: 4 × JGA25-370 - ход A, ход B, гайковёрт, Junior. Сервоприводы: 4 × MG996R полозья, 5 × MG90S (камера, магнит, гайковёрт, фишки, запас). NEMA17 №1 телескоп, №2 свободен.
- Питание: моторы и A4988 от VBAT (ШИМ ≤ 80 %), 6,0 В серво и помпа, 5,1 В Pi 5, 5,0 В ESP B. Все датчики 3,3 В. ~35 Вт, ~0,85 ч.
- Листы 1:2: фанера 4 - 1672 см², оргстекло 3 - 706, фанера 6 - 220 (полозья) - всё в лимите 3200. Пластик: колёса + телескоп + ремонт + кронштейны ≈ 400 г из 800.
- Укрытие: корпус ниже УГР (верх 81 < 100), лидар 113 < 117 (низ необрессоренных частей поезда по ГОСТ 9238 минус запас), робот внутри колёс поезда (|Y| ≤ 345). Это главный аргумент «правильности» 1:2 - в паспорте он есть.
- Момент полозьев: ≤ 4,8 кг·см при 3,2 кг, MG996R 9,4-11 - запас 2.
