Wexito11/Force-1-Hardato/docs/pismo-organizatoram.md

# Письмо организаторам (черновик для чата заочного этапа)

Отправить от капитана после объявления результатов отбора (или раньше, если в чате принимают вопросы). Короткие вопросы, по одному на строку, чтобы на них было легко ответить.

---

Добрый день! Команда «Форс-1». Чтобы подготовиться к финалу, уточните, пожалуйста, несколько вопросов по комплектующим и материалам.

**Комплектующие (Приложение 1)**
1. Raspberry Pi - какая модель в наборе (4 или 5)? От этого зависит питание: Pi 5 нужно 5 В 5 А.
2. Аккумуляторы 18650 к держателю 4×18650 выдаются? В Приложении 2 есть «4S» - это они?
3. ESP32-WROOM в наборе один. Можно ли второй по согласованию, или использовать ESP32-ETH01 из Приложения 1 как второй контроллер?
4. К модулям AS5600 прилагаются диаметральные магниты Ø6×2,5?
5. Сколько RFID-меток в комплекте с RC522? Нам нужно 2-4.
6. Шлейф камеры Raspberry Pi: для Pi 5 нужен переходной 22-15 pin. Есть ли он?

**По согласованию (Приложение 2)**
7. Помпа для маркировки дефекта краской. Если да - можно ли силиконовую трубку Ø6 (~0,5 м) и краску/чернила?
8. Мотор-редуктор JGA 77 об/мин для гайковёрта (вместо JGA25-370, нужен момент).
9. Драйвер MX1508 или DRV8833 для учебной версии (оба L298N заняты в роботе).
10. Предохранитель 7,5 А с держателем и обратный диод (1N4007) на электромагнит - их нет в списках, можно ли?
11. Резисторы 1 кОм и 2 кОм (делитель echo HC-SR04), 2 комплекта.

**Материалы**
12. Демонстрационный путь (рельсы и шпалы из фанеры 10 и 6 мм, ~1 м) - входит ли он в лимит команды 3200 см² на материал, или для полигона есть общий материал?
13. Можно ли использовать пружины? В списках их нет; если нет - телескоп сводится и разводится мотором, пружины не нужны.

**Оборудование на финале**
14. 3D-принтеры: какие модели, поле печати 201×201×210 - это один принтер на команду? Есть ли PETG или только PLA?
15. Лазер 500×300: режет ли фанеру 10 мм за один проход?

Спасибо!

---

## После ответа

Записать ответы в «Сверку» (раздел 2) и в `Форс-1_компоненты.xls` (столбец «Примечание»), обновить «Контекст Форс-1».
