Wexito11/Force-1-Hardato/docs/zashchita.md

# Защита на финале: 5 минут

Файл презентации: `Презентация_«Форс-1».pdf` (или .pptx) на флешке. После 5 минут выступление прерывают, поэтому демонстрация идёт параллельно с рассказом, а не после.

## Хронометраж

| Время | Слайд | Кто говорит | Что происходит на столе |
|---|---|---|---|
| 0:00-0:30 | 1. Проблема: 85 тыс. км пути, люди на путях, допуски в миллиметры | капитан | робот стоит на тест-рейке / пути, включён |
| 0:30-1:00 | 2. Идея: два модуля, телескоп = измеритель колеи, укрытие под поездом | капитан | - |
| 1:00-2:00 | 3. Конструкция 1:2: корпуса, колёса с ребордой, телескоп из профилей, полозья | У1 / У2 | показать телескоп рукой: сжать-разжать |
| 2:00-3:00 | 4. Инспекция: что меряем и чем (таблица датчиков) | У3 | **демо 1**: робот едет по рейке, на экране появляются дефекты с координатами |
| 3:00-3:45 | 5. Обслуживание: краска, магнит, гайковёрт | У4 | **демо 2**: магнит снимает гайку, гайковёрт на болте стыка |
| 3:45-4:30 | 6. Режим укрытия | капитан | **демо 3**: кнопка «Укрытие», полозья вниз, телескоп сжат, доска-«вагон» проходит, камера показывает дно |
| 4:30-5:00 | 7. Развитие: реальная колея, ультразвук, рой, Junior | капитан | робот возвращается на рельсы |

## Правила
- Демо запускает один человек с ноутбука, второй страхует робота рукой.
- Каждое демо отрепетировано минимум 3 раза накануне, время записано.
- Запасной сценарий, если что-то не едет: показать узел рукой и видео с телефона (снять заранее на репетиции).
- Вопросы экспертов, к которым готовимся: момент на болте в реальности (честно: не хватит, это этап 4); как робот узнаёт о поезде (команда диспетчера + вибрация); почему 1:2 (укрытие ниже УГР, в 1:8 невозможно); сколько стоит (57 тыс. руб. прототип).

## Слайды (черновик содержания)
1. Титул: «Форс-1», команда, МГТУ.
2. Проблема - 3 цифры с источниками из паспорта.
3. Идея - рендер 1 и схема укрытия (рендер 2).
4. Конструкция - рендер 5 + габаритная схема ГЧ1.
5. Инспекция - таблица «параметр - датчик - порог» + скрин веб-панели.
6. Обслуживание - рендер 4 (ремонтный модуль).
7. Укрытие - 4 этапа (рис. из концепции).
8. Развитие + Junior.
9. Спасибо, вопросы.
