Wexito11/Force-1-Hardato/docs/ФОРС1_Схема_алгоритма.pdf

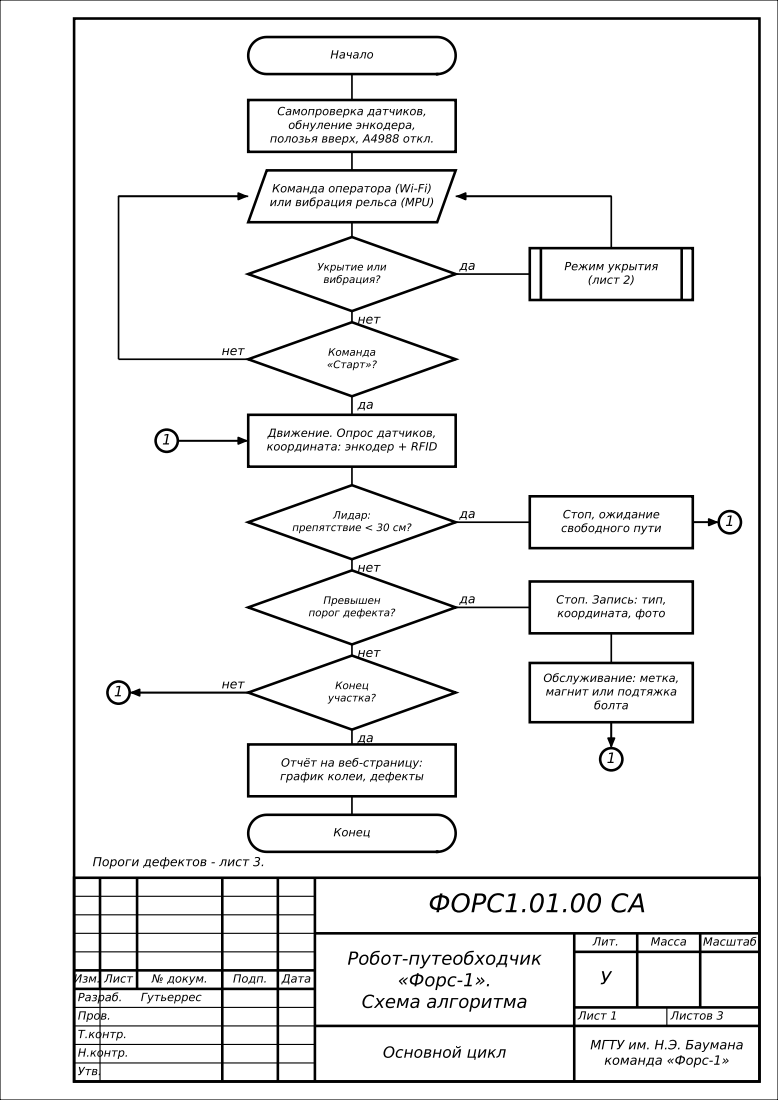
[picture p14: page 1]
Изм. Лист; № докум.; Подп.; Дата; Разраб. Пров. Т.контр. Н.контр. Утв.; Гутьеррес; ФОРС1.01.00 СА; Робот-путеобходчик «Форс-1». Схема алгоритма; Основной цикл; Лит.; Масса; Масштаб; Лист 1; Листов 3; Начало; Укрытие или вибрация?; Команда «Старт»?; Лидар: препятствие < 30 см?; Превышен порог дефекта?; Конец участка?; Конец; нет; Режим укрытия (лист 2); Стоп, ожидание свободного пути

Самопроверка датчиков,
обнуление энкодера,
полозья вверх, A4988 откл.

Команда оператора (Wi-Fi)
или вибрация рельса (MPU)

Движение. Опрос датчиков,
координата: энкодер + RFID

Стоп. Запись: тип,
координата, фото

Обслуживание: метка,
магнит или подтяжка
болта

Отчёт на веб-страницу:
график колеи, дефекты

Пороги дефектов - лист 3.

МГТУ им. Н.Э. Баумана
команда «Форс-1»

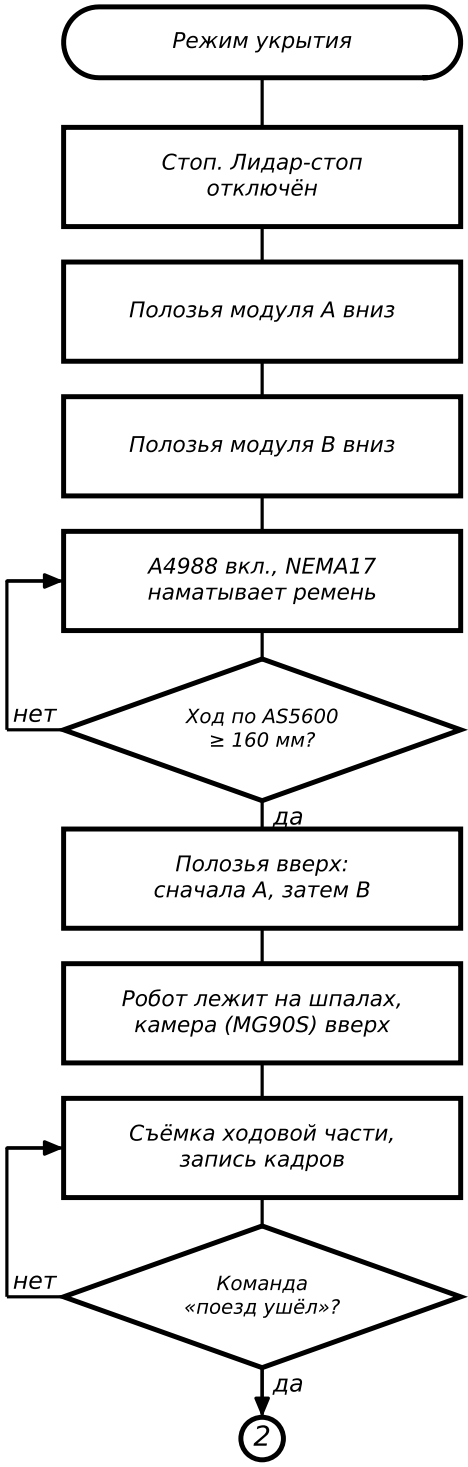
[picture p15: figure]
Режим укрытия; Стоп. Лидар-стоп отключён; Полозья модуля A вниз; Полозья модуля B вниз; A4988 вкл., NEMA17 наматывает ремень; Ход по AS5600 ≥ 160 мм?; Полозья вверх: сначала A, затем B; Робот лежит на шпалах, камера (MG90S) вверх; Съёмка ходовой части, запись кадров; Команда «поезд ушёл»?; нет

Изм. Лист | № докум. | Подп. | Дата
Разраб. | Гутьеррес

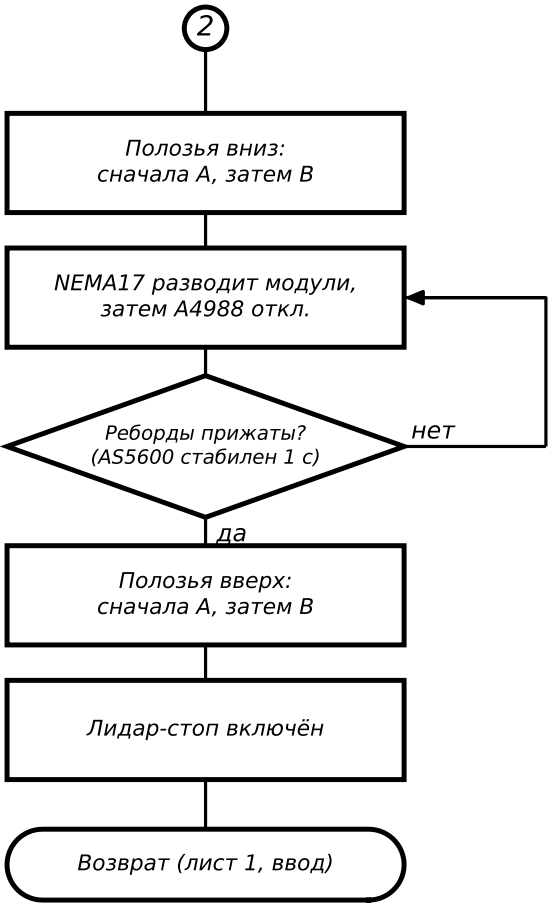
[picture p16: figure]
Полозья вниз: сначала A, затем B; NEMA17 разводит модули, затем A4988 откл.; Реборды прижаты? (AS5600 стабилен 1 с); Полозья вверх: сначала A, затем B; Лидар-стоп включён; Возврат (лист 1, ввод); нет

## ФОРС1.01.00 СА

## Робот-путеобходчик

«Форс-1».

## Схема алгоритма

### Режим укрытия

Лит. | Масса | Масштаб
У
Лист 2 | Листов 3

Примечания:
1. Полозья опускаются и поднимаются по очереди, чтобы ограничить пиковый ток линии 6 В
(4 x MG996R).
2. В режиме укрытия лидар-стоп отключён: поезд над роботом не должен блокировать алгоритм.
3. Вибрация рельса (MPU-9250) проверяется только на стоянке, иначе ложные срабатывания от собственного хода.

Изм. Лист | № докум. | Подп. | Дата
Разраб. | Гутьеррес

## ФОРС1.01.00 СА

## Робот-путеобходчик

«Форс-1».

## Схема алгоритма

### Состояния и пороги

Лит. | Масса | Масштаб
У
Лист 3 | Листов 3

### Таблица 1 - Состояния и переходы

Код | Состояние | Действие | Переход
S0 | Инициализация | самопроверка, обнуление | OK → S1
S1 | Ожидание | стоит, слушает команды и MPU | старт → S2; укрытие → S7
S2 | Езда и измерения | опрос датчиков, координата | порог → S3; лидар → S6; конец → S5
S3 | Дефект | стоп, запись, фото | → S4
S4 | Обслуживание | метка / магнит / болт | готово или тайм-аут → S2
S5 | Отчёт | данные на веб-страницу | → S1
S6 | Препятствие | стоп, ждать > 30 см | чисто → S2
S7 | Полозья вниз | A, затем B | → S8
S8 | Сжатие телескопа | NEMA17 до хода 160 мм (AS5600)→ S9
S9 | Полозья вверх | робот на шпалах | → S10
S10 | Осмотр поезда | камера снизу, лидар-стоп откл. | «поезд ушёл» → S11
S11 | Возврат | в обратном порядке | → S1

### Таблица 2 - Пороги дефектов (прототип 1:2)

Параметр | Датчик | Порог | Действие
Ширина колеи | AS5600 (телескоп) | |Δ| > 8 мм (колея 760) | запись, метка
Перекос | MPU-9250 | крен > 0,8° | запись, метка
Износ головки | TOF250 вниз | d - d0 > 8 мм | запись, метка
Стык | TOF250 + энкодер, камера | провал > 12 мм | фото болтов, подтяжка
Шпалы | HC-SR04 вниз + энкодер шаг вне 272 ± 40 мм | | запись
Мусор | камера | металл на пути | электромагнит
Препятствие | RPLIDAR C1 | < 30 см | стоп
