Wexito11/Force-1-Hardato/cad/ФОРС1_1к2_Габаритная_схема.pdf

Изм. Лист | № докум. | Подп. | Дата
Разраб. Пров. Т.контр. Н.контр. Утв. | Гутьеррес

## ФОРС1.00.00.000 ГЧ1

Робот 1:2 на пути 760.

## Габаритная схема

Лит. | Масса | Масштаб
У | 1:5
Лист 1 | Листов 1
МГТУ им. Н.Э. Баумана
команда «Форс-1»

УГР

П 20x20 / 15x10

## А-А. На рельсах (инспекция)

760 (колея)

502 (зазор)

УГР зона укрытия: |Y| ≤ 345, Z ≤ 117 необрессоренные части поезда: низ 32.5 над УГР (ГОСТ 9238: 65 / 2)

П 20x20 / 15x10

## Б-Б. Режим укрытия: колёсная пара поезда 1:2 (Ø475, 720 между гранями)

680 по колёсам ≤ 690

720

Проверка | Норма 1:2 | Модель
Высота в укрытии над шпалой | ≤ 117 (УГР 100 + 32,5 - 15) 113 (лидар)
Ширина в укрытии | ≤ 690 (720 - 2x15) | 680
Рейка в укрытии |Y| | ≤ 345 | 345
Колёса над рельсом при переходе | > 0 | 10
Момент MG996R, 0,8 кг на серво | ≤ 9,4 кг·см | 4,8
Ход модуля / общий | - | 80 / 160
1. Путь 1:2 к Р65 на ж/б шпалах: колея 760, головка 37,5,
УГР 100 над шпалой (рельс 90 + подкладка 10).
2. Колёсная пара поезда 1:2: 720 между внутр. гранями, гребень 14 x 16,5. Низ необрессоренных частей поезда - 65 мм над УГР (ГОСТ 9238), в 1:2 - 32,5.
3. В укрытии робот ниже частей поезда на 15 и не ближе 15 к грани колеса.
4. Лидар на крышке A, утоплен в вырез; верх 113 < 117. Камера под крышкой.
