Wexito11/Force-1-Hardato/cad/ФОРС1_Натурный_габарит.pdf

Изм. Лист | № докум. | Подп. | Дата
Разраб. Пров. Т.контр. Н.контр. Утв. | Гутьеррес

## ФОРС1.00.00.000 ГЧ2

Натурный образец.

## Габаритная схема

Лит. | Масса | Масштаб
У | 1:10
Лист 1 | Листов 1
МГТУ им. Н.Э. Баумана
команда «Форс-1»

шпала ж/б 2750

колесо поезда Ø950

УГР

## ЗОНА УКРЫТИЯ РОБОТА

ширина ≤ 1380, высота ≤ 235 над шпалой

1520 (колея)

1440 (между внутр. гранями колёс)

1380

~200

Параметр | Натура | Прототип 1:2 | Норма для 1:2
Колея | 1520 | 760 | 760
Рельс над шпалой (УГР) | ~200 (Р65 + подкладка) | 100 | 100
Внутр. грани колёс поезда | 1440 | - | 720
Робот лёжа: высота над шпалой ≤ 235 (УГР + 65 - 30) | 113 x 2 = 226 | ≤ 117
Робот лёжа: ширина | ≤ 1380 | 680 (рейка 690) | ≤ 690
Колёса робота в укрытии | внутри зоны | внутри зоны | -

Требования к натурному образцу:
1. В режиме укрытия робот ниже необрессоренных частей подвижного состава (65 мм над УГР по ГОСТ 9238, запас 30 мм) и внутри внутренних граней колёс поезда (запас 30 мм на сторону).
2. Колёса робота в укрытии убираются внутрь зоны (поворот на рычагах полозьев) или имеют Ø ≤ 140.
3. Лидар утоплен в крышку модуля A, камера смотрит вверх через окно крышки.
4. Части робота выше УГР в рабочем режиме сверять с нижним очертанием габарита ГОСТ 9238-2013.
5. Прототип выполнен в масштабе 1:2 с теми же требованиями (лист ФОРС1.00.00.000 ГЧ1).
Размеры Р65, ж/б шпалы и подкладки - номинальные, высота УГР над шпалой приблизительная.
