Wexito11/Force-1-Hardato/cad/renders/5_укрытие_крупно.png

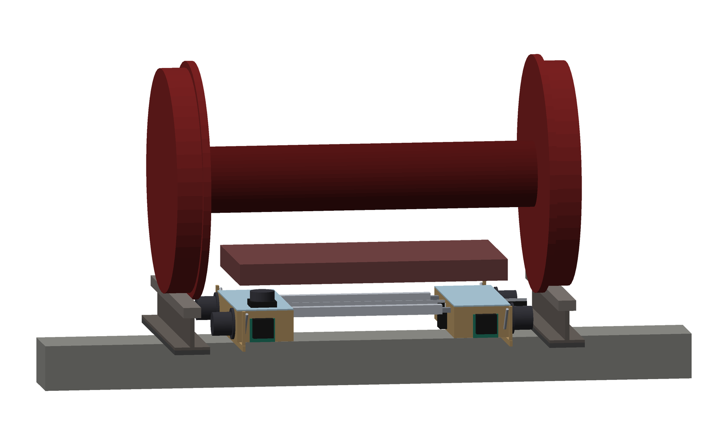
cad/renders/5_укрытие_крупно.png
