Wexito11/Force-1-Hardato/electronics/Форс-1_компоненты.xls

Sheet: Компоненты
Форс-1 - таблица компонентов (к схеме ФОРС1.00.00.000 Э3)
Жёлтым - позиции не из Прил. 1 (нужно согласование). «Остаток» = выделено - занято по всем строкам этой позиции.
№ | Поз. обозн. | Наименование | Кол. | Модуль | Назначение | Приложение | Выделено на команду | Занято всего | Остаток | Примечание
1 | A1 | Raspberry Pi 5 | 1 | A | Верхний уровень: веб-панель, камера, лидар, связь с ESP A/B | Прил. 1 | 1 | 1 | 0 | В Прил. 1 «Raspberry Pi» - модель Pi 5
2 | A2 | ESP32-ETH01 (ESP A) | 1 | A | Мотор хода A, гайковёрт, датчики A, I2C | Прил. 1 | 1 | 1 | 0 | Ethernet не используется
3 | A3 | ESP32-WROOM (ESP B) | 1 | B | Мотор хода B, NEMA17, датчики B, RFID | Прил. 1 | 1 | 1 | 0
4 | A3.1 | Плата расширения для ESP32-WROOM | 1 | B | Клеммы для монтажа ESP B | Прил. 1 | 1 | 1 | 0
5 | A4 | Драйвер моторов L298N | 1 | A | Ход A (кан. A), гайковёрт (кан. B) | Прил. 1 | 2 | 2 | 0
6 | A5 | Драйвер моторов L298N | 1 | B | Ход B | Прил. 1 | 2 | 2 | 0 | Всего 2 из 2
7 | A6 | Драйвер шагового двигателя A4988 | 1 | B | NEMA17 натяжения ремня телескопа | Прил. 1 | 2 | 1 | 1
8 | A7 | Серво-шилд PCA9685 | 1 | A | 5 серво модуля A + ключи гайковёрта и LR7843 | Прил. 1 | 1 | 1 | 0
9 | A8 | MOSFET-модуль LR7843 | 1 | A | Ключ электромагнита YA1 | Прил. 1 | 2 | 2 | 0
10 | A9 | MOSFET-модуль LR7843 | 1 | A | Ключ помпы M12 | Прил. 1 | 2 | 2 | 0 | Всего 2 из 2
11 | A10 | RFID-модуль | 1 | B | Метки-пикеты на шпалах | Прил. 1 | 1 | 1 | 0 | 3,3 В, SPI
12 | A11 | Лидар RPLIDAR C1 | 1 | A | Препятствия (стоп < 30 см) | Прил. 1 | 1 | 1 | 0 | USB к Pi
13 | A12 | Камера Raspberry Pi v1.3 | 1 | A | Фото дефектов, осмотр поезда снизу | Прил. 1 | 1 | 1 | 0 | к Pi 5 - шлейф 15/22
14 | B1 | Лазерный дальномер TOF250 | 1 | A | Износ головки рельса A, провал стыка | Прил. 1 | 2 | 2 | 0
15 | B2 | Лазерный дальномер TOF250 | 1 | B | Износ головки рельса B, провал стыка | Прил. 1 | 2 | 2 | 0 | Всего 2 из 2
16 | B3 | Ультразвуковой дальномер HC-SR04 | 1 | A | Шпалы (шаг 272, пропуск) - вниз через дно, 85 мм до шпалы | Прил. 1 | 4 | 3 | 1 | 1:2: HW-511 не достаёт до шпалы (85 мм) - заменён на HC-SR04; echo 5 В через делитель 1k/2k
17 | B4 | Ультразвуковой дальномер HC-SR04 | 1 | B | Шпалы (шаг 272, пропуск) - вниз через дно, 85 мм до шпалы | Прил. 1 | 4 | 3 | 1 | Занято 3 из 4 (третий - Junior); HW-511 ×3 в роботе не используются
18 | B5 | Оптический датчик скорости LM393 + диск | 1 | A | Энкодер хода A (координата) | Прил. 1 | 2 | 2 | 0
19 | B6 | Оптический датчик скорости LM393 + диск | 1 | B | Энкодер хода B | Прил. 1 | 2 | 2 | 0 | Всего 2 из 2
20 | B7 | Гироскоп/акселерометр MPU-9250 | 1 | A | Перекос (крен), вибрация рельса | Прил. 1 | 1 | 1 | 0 | I2C 0x68
21 | B8 | Магнитный энкодер AS5600 | 1 | B | №1: ширина колеи (шкив телескопа) | Прил. 1 | 2 | 2 | 0 | I2C 0x36, шина ESP B
22 | B9 | Магнитный энкодер AS5600 | 1 | A | №2: остановка гайковёрта | Прил. 1 | 2 | 2 | 0 | I2C 0x36, шина ESP A
23 | FU1 | Предохранитель 7,5 А с держателем | 1 | B | Защита от КЗ | нет | 0 | - | - | Нет в Прил. 1-2 - по согласованию
24 | GB1 | Держатель 4×18650 | 1 | B | Батарея 14,8 В | Прил. 1 | 1 | 1 | 0
25 | GB1.1 | Аккумуляторы 18650 (4S) | 4 | B | Батарея 14,8 В | Прил. 2 | по согл. | - | - | Прил. 2 «Аккумуляторы 4S» - по согласованию
26 | M1 | Мотор-редуктор JGA25-370 12V | 1 | A | Ход модуля A | Прил. 1 | 4 | 3 | 1
27 | M2 | Мотор-редуктор JGA25-370 12V | 1 | B | Ход модуля B | Прил. 1 | 4 | 3 | 1
28 | M3 | Мотор-редуктор JGA25-370 12V | 1 | A | Гайковёрт (ремонт) | Прил. 1 | 4 | 3 | 1 | Занято 3 из 4
29 | M4 | Шаговый мотор NEMA17 17HS4401S | 1 | B | Сведение модулей (ремень GT2) | Прил. 1 | 2 | 1 | 1
30 | M5 | Сервопривод MG996R | 1 | A | Полоз A1 | Прил. 1 | 4 | 4 | 0
31 | M6 | Сервопривод MG996R | 1 | A | Полоз A2 | Прил. 1 | 4 | 4 | 0
32 | M7 | Сервопривод MG996R | 1 | B | Полоз B1 | Прил. 1 | 4 | 4 | 0
33 | M8 | Сервопривод MG996R | 1 | B | Полоз B2 | Прил. 1 | 4 | 4 | 0 | Всего 4 из 4
34 | M9 | Сервопривод MG90S | 1 | A | Наклон камеры | Прил. 1 | 5 | 3 | 2
35 | M10 | Сервопривод MG90S | 1 | A | Рычаг электромагнита | Прил. 1 | 5 | 3 | 2
36 | M11 | Сервопривод MG90S | 1 | A | Опускание гайковёрта | Прил. 1 | 5 | 3 | 2 | Занято 3 из 5
37 | M12 | Помпа | 1 | A | Маркировка дефекта краской | Прил. 2 | по согл. | - | - | Прил. 2 - по согласованию
38 | P1 | Вольтметр-амперметр XFW-001 | 1 | B | Контроль напряжения и тока батареи | Прил. 1 | 1 | 1 | 0
39 | SA1 | Тумблер большой | 1 | B | Главный выключатель | Прил. 1 | 1 | 1 | 0
40 | U1 | Понижающий преобразователь XH-M400 | 1 | A | +6 В сервоприводы, помпа (8 А) | Прил. 1 | 2 | 2 | 0
41 | U2 | Понижающий преобразователь XH-M400 | 1 | A | +5,1 В Raspberry Pi 5, ESP A (8 А) | Прил. 1 | 2 | 2 | 0 | Всего 2 из 2
42 | U3 | Понижающий преобразователь LM2596 | 1 | B | +5 В ESP B (3 А) | Прил. 1 | 1 | 1 | 0
43 | W1 | Жгут через телескоп, 7 жил | 1 | A-B | VBAT, GND, +6V, UART - вдоль П-профиля телескопа, петля ≥ 200 мм (ход 160) | нет | 0 | - | - | Провода - уточнить у организаторов
44 | XP1, XS1 | Разъём 7-конт. (или пайка) | 2 | A-B | Отсоединение модулей | нет | 0 | - | - | По согласованию; без них - пайка
45 | YA1 | Электромагнит BR-P25/11 | 1 | A | Уборка металлического мусора | Прил. 1 | 1 | 1 | 0
46 | - | USB-UART PL2303HX | 1 | - | Прошивка ESP A (резерв к прошивке с Pi) | Прил. 1 | 1 | 1 | 0 | Не на роботе
 | Из Прил. 1 не используются / резерв:
 |  | Преобразователь логических уровней 4 кан. | 1 |  | Резерв: все датчики на 3,3 В
 |  | Мотор-редуктор JGA25-370 12V | 1 |  | Свободен (резерв гайковёрта)
 |  | Датчик линии HW-511 | 2 |  | Свободны (1:2 заменены на HC-SR04); 1 шт. - Junior
 |  | Сервопривод MG90S | 2 |  | Свободны (1 - сброс фишек, если помпу не согласуют)
 |  | Шаговый мотор NEMA17 + A4988 | 1 |  | Свободны (вариант гайковёрта)
 |  | Резисторы 1 кОм + 2 кОм (делитель echo HC-SR04) | 2 |  | Нет в Прил. 1 - по согласованию (или 3 × 1 кОм)

Sheet: Распиновка
Контроллер | Вывод | Функция | Куда (поз.) | Интерфейс | Уровень
ESP A (ETH01) A2 | IO4 | ENA - ШИМ хода A | A4 | PWM | 3,3 В
ESP A (ETH01) A2 | IO17 | IN1 хода A | A4 | GPIO | 3,3 В
ESP A (ETH01) A2 | IO32 | IN2 хода A | A4 | GPIO | 3,3 В
ESP A (ETH01) A2 | IO33 / IO14 | SDA / SCL: MPU-9250 0x68, AS5600 №2 0x36, PCA9685 0x40 | B7, B9, A7 | I2C | 3,3 В
ESP A (ETH01) A2 | IO39 | RX1 ← TX TOF250 | B1 | UART1 | 3,3 В
ESP A (ETH01) A2 | IO35 | Энкодер хода A | B5 | GPIO in | 3,3 В
ESP A (ETH01) A2 | IO36 / IO12 | ECHO (через делитель 1k/2k) / TRIG HC-SR04 шпалы | B3 | GPIO in / out | 3,3 В (echo 5 В → делитель)
ESP A (ETH01) A2 | IO1 / IO3 | TX0 / RX0 ↔ Pi GPIO5 / GPIO4 (UART2) | A1 | UART0 | 3,3 В
ESP A (ETH01) A2 | EN / IO0 | Сброс / режим прошивки ← Pi GPIO17 / GPIO27 | A1 | GPIO | 3,3 В
ESP A (ETH01) A2 | IO2, IO5, IO15 | Свободны (strap-выводы, резерв); IO12 - TRIG HC-SR04 | - | - | -
PCA9685 A7 | CH0-CH2 | MG90S: камера, рычаг магнита, гайковёрт | M9-M11 | PWM 50 Гц | 6 В питание
PCA9685 A7 | CH3, CH4 | MG996R полозья A1, A2 | M5, M6 | PWM 50 Гц | 6 В питание
PCA9685 A7 | CH8 / CH9 / CH10 | ENB / IN3 / IN4 гайковёрта | A4 | PWM/логика | 3,3 В
PCA9685 A7 | CH11 / CH12 | SIG ключа помпы / электромагнита | A9 / A8 | PWM | 3,3 В
ESP B (WROOM) A3 | 25 / 26 / 27 | ENA / IN1 / IN2 хода B | A5 | PWM+GPIO | 3,3 В
ESP B (WROOM) A3 | 32 / 33 / 4 | STEP / DIR / EN A4988 | A6 | GPIO | 3,3 В
ESP B (WROOM) A3 | 21 / 22 | SDA / SCL AS5600 №1 0x36 | B8 | I2C | 3,3 В
ESP B (WROOM) A3 | 16 / 17 | RX2 / TX2 TOF250 | B2 | UART2 | 3,3 В
ESP B (WROOM) A3 | 18 / 19 / 23 / 5 / 13 | SCK / MISO / MOSI / SS / RST RFID | A10 | SPI | 3,3 В
ESP B (WROOM) A3 | 34 | Энкодер хода B | B6 | GPIO in | 3,3 В
ESP B (WROOM) A3 | 35 / 2 | ECHO (через делитель 1k/2k) / TRIG HC-SR04 шпалы | B4 | GPIO in / out | 3,3 В (echo 5 В → делитель)
ESP B (WROOM) A3 | 14 / 15 | MG996R полозья B1, B2 | M7, M8 | PWM 50 Гц | 6 В питание
ESP B (WROOM) A3 | 1 / 3 | TX0 / RX0 ↔ Pi GPIO15 / GPIO14 через телескоп | XS1 4, 5 | UART0 | 3,3 В
Raspberry Pi 5 A1 | конт. 2, 4 / 6 | +5,1 В от U2 / GND | U2 | питание | 5,1 В
Raspberry Pi 5 A1 | GPIO14 / GPIO15 (8 / 10) | UART0 ↔ ESP B (жгут W1) | XP1 5, 4 | UART0 | 3,3 В
Raspberry Pi 5 A1 | GPIO4 / GPIO5 (7 / 29) | UART2 ↔ ESP A (dtoverlay=uart2-pi5) | A2 | UART2 | 3,3 В
Raspberry Pi 5 A1 | GPIO17 / GPIO27 (11 / 13) | EN / IO0 ESP A (прошивка esptool) | A2 | GPIO | 3,3 В
Raspberry Pi 5 A1 | CSI0 | Камера v1.3 (шлейф 15/22) | A12 | CSI | -
Raspberry Pi 5 A1 | USB | RPLIDAR C1 (родной адаптер) | A11 | USB | 5 В

Sheet: Питание
Расчёт питания (оценки по типовым даташитам; синие ячейки - исходные данные, менять при уточнении)
Напряжение батареи номинальное, В | 14.8
Ёмкость элемента 18650, А·ч | 2.5 | уточнить у организаторов
КПД понижающих преобразователей | 0.88
Используемая доля ёмкости | 0.8
Потребитель | Шина | Кол. | Ток ном., А (1 шт.) | Ток пик, А (1 шт.) | Ном. всего, А | Пик всего, А | Комментарий
JGA25-370 ход A, B | VBAT | 2 | 0.40 | 2.00 | 0.80 | 4.00 | через L298N, ШИМ ≤ 80 %
JGA25-370 гайковёрт | VBAT | 1 | 0.00 | 2.00 | 0.00 | 2.00 | работает только при ремонте
NEMA17 через A4988 | VBAT | 1 | 0.30 | 1.00 | 0.30 | 1.00 | на рельсах A4988 выключен
Электромагнит BR-P25/11 | VBAT | 1 | 0.00 | 0.30 | 0.00 | 0.30 | кратковременно
MG996R полозья | +6V | 4 | 0.10 | 2.50 | 0.40 | 10.00 | пик - при подъёме; по очереди
MG90S | +6V | 3 | 0.05 | 0.70 | 0.15 | 2.10
Помпа | +6V | 1 | 0.00 | 0.50 | 0.00 | 0.50 | оценка, уточнить по помпе
Raspberry Pi 5 | +5V1 | 1 | 1.50 | 2.50 | 1.50 | 2.50 | без нагрузки на USB, кроме лидара
RPLIDAR C1 | +5V1 | 1 | 0.30 | 0.40 | 0.30 | 0.40 | через USB Pi
Камера v1.3 | +5V1 | 1 | 0.25 | 0.25 | 0.25 | 0.25 | через CSI Pi
ESP A + датчики A (3,3 В) | +5V1 | 1 | 0.25 | 0.45 | 0.25 | 0.45 | ETH01 + MPU, AS5600, TOF, HC-SR04, LM393, PCA VCC
ESP B + датчики B + RFID | +5V_B | 1 | 0.30 | 0.55 | 0.30 | 0.55 | WROOM + RFID, AS5600, TOF, HC-SR04, LM393
Шина / источник | U, В |  | Ном., А | Пик, А | Ном., Вт | Предел источника, А | Запас по пику
VBAT напрямую (L298N, A4988, YA1) | 14.8 |  | 1.10 | 7.30 | 16.3 | 7.5 | 0.20
+6V - U1 XH-M400 | 6.0 |  | 0.55 | 7.60 | 3.3 | 8 | 0.40
+5V1 - U2 XH-M400 | 5.1 |  | 2.30 | 3.60 | 11.7 | 8 | 4.40
+5V_B - U3 LM2596 | 5.0 |  | 0.30 | 0.55 | 1.5 | 3 | 2.45
Мощность от батареи, ном., Вт | 35.06
Ток батареи, ном., А | 2.37
Ток батареи, пик, А (оценка) | 12.42 | пик всех потребителей сразу не бывает: серво и гайковёрт по очереди
Энергия батареи (4S1P), Вт·ч | 37.00
Время работы, ч | 0.84

Sheet: Жгут W1
Конт. XS1/XP1 | Цепь | Откуда | Куда | Провод | Ток, А
1 | VBAT | B: SA1-FU1 | A: U1, U2, L298N A, LR7843 A8 | 0,5 мм² | 6
2 | VBAT | параллельно конт. 1 |  | 0,5 мм² | 6
3 | +6V | A: U1 | B: MG996R M7, M8 | 0,5 мм² | 3
4 | TX B | B: ESP B IO1 | A: Pi GPIO15 (RXD0) | 0,12 мм² | сигн.
5 | RX B | B: ESP B IO3 | A: Pi GPIO14 (TXD0) | 0,12 мм² | сигн.
6 | GND | B: GB1- через P1 | A: общий | 0,5 мм² | 6
7 | GND | параллельно конт. 6 |  | 0,5 мм² | 6
Итого 5 цепей / 7 жил. Длина - ход телескопа 160 мм + петля ≥ 200 мм, провод гибкий, вдоль П-профиля телескопа (масштаб 1:2, труб нет).
