Wexito11/Force-1-Hardato/cad/renders/small_parts.png

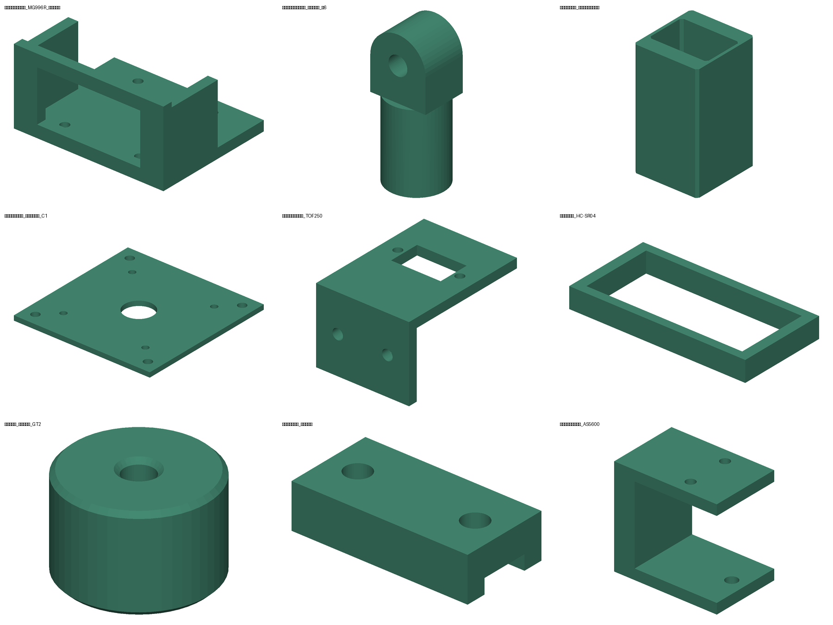
cad/renders/small_parts.png
