Wexito11/Force-1-Hardato/cad/dxf/ФОРС1_1к2_корпуса_фанера4_лист2.dxf

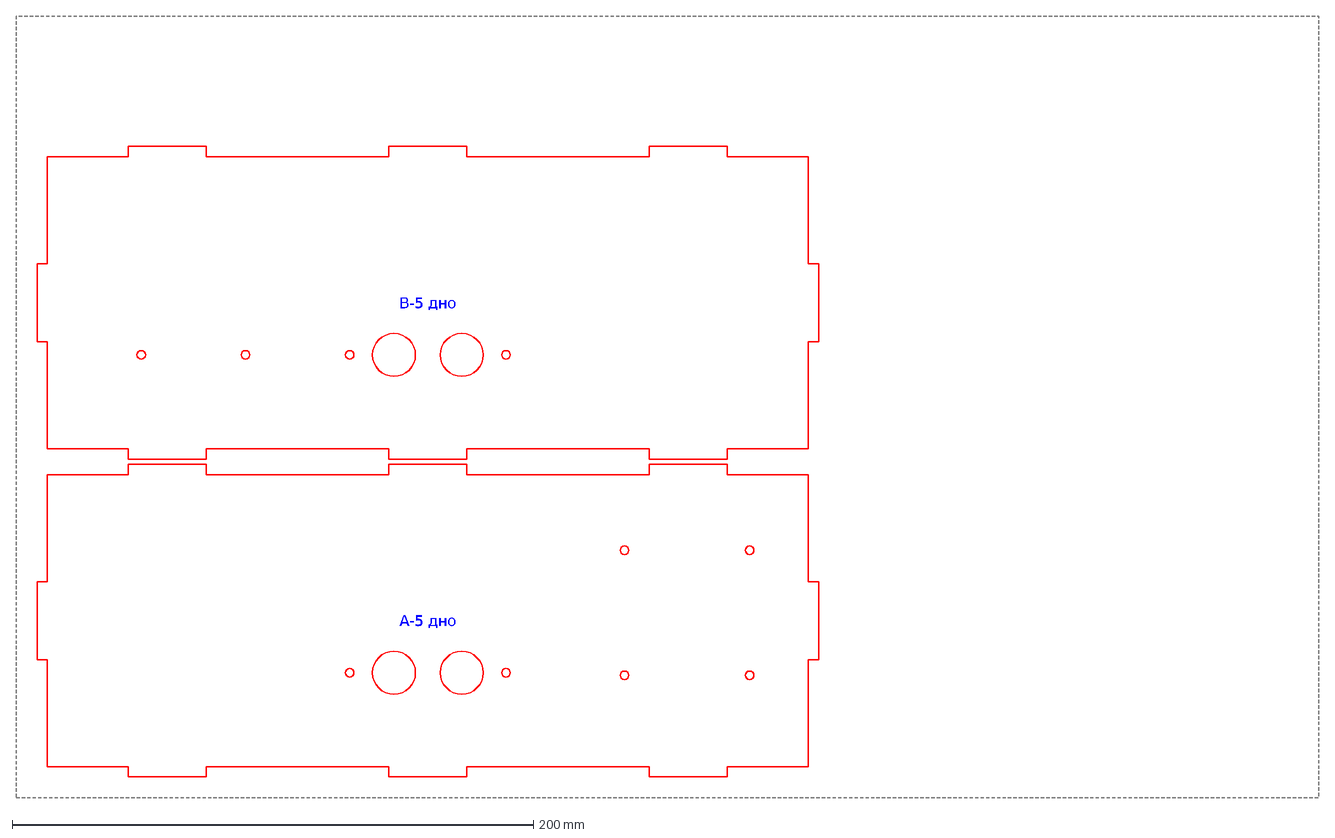
[picture p33: CAD file, 2026-11-08]
cad/dxf/ФОРС1_1к2_корпуса_фанера4_лист2.dxf
A-5 дно
B-5 дно
