Wexito11/Force-1-Hardato/cad/step/Кронштейн_MG996R_торец.step

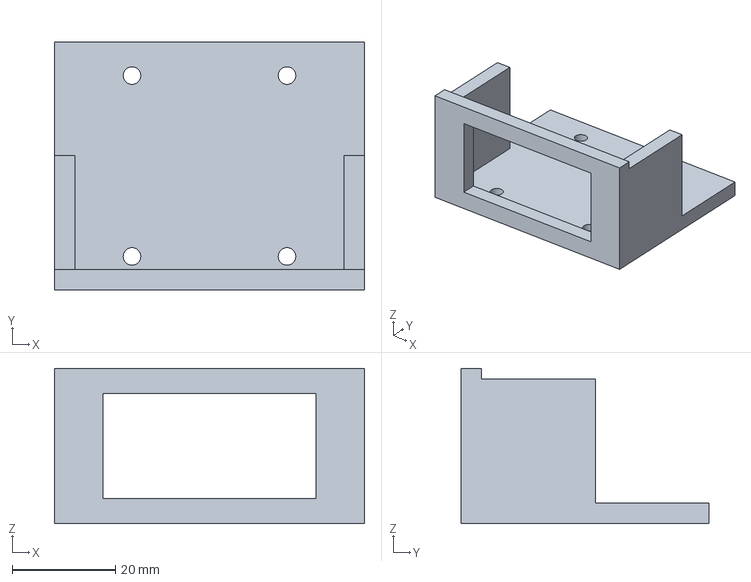
[picture p34: CAD file, 2026-11-08]
cad/step/Кронштейн_MG996R_торец.step
60.0 x 48.0 x 30.0 mm
