Wexito11/Force-1-Hardato/cad/stl/small/Держатель_AS5600.stl

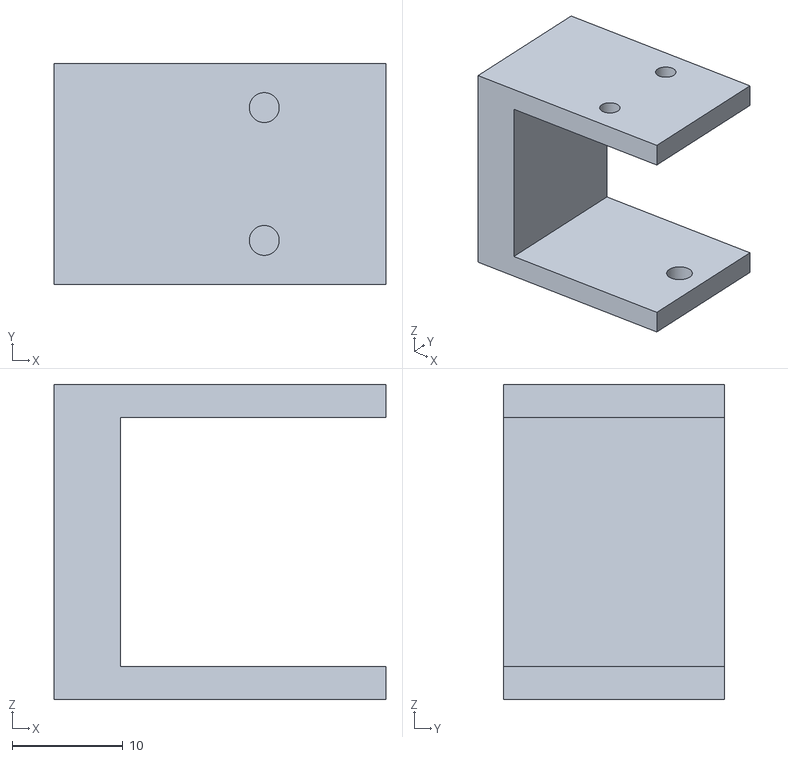
[picture p35: CAD file, 2026-11-08]
cad/stl/small/Держатель_AS5600.stl
30.0 x 20.0 x 28.5
