Wexito11/Force-1-Hardato/cad/dxf/ФОРС1_1к2_корпуса_фанера4_лист1.dxf

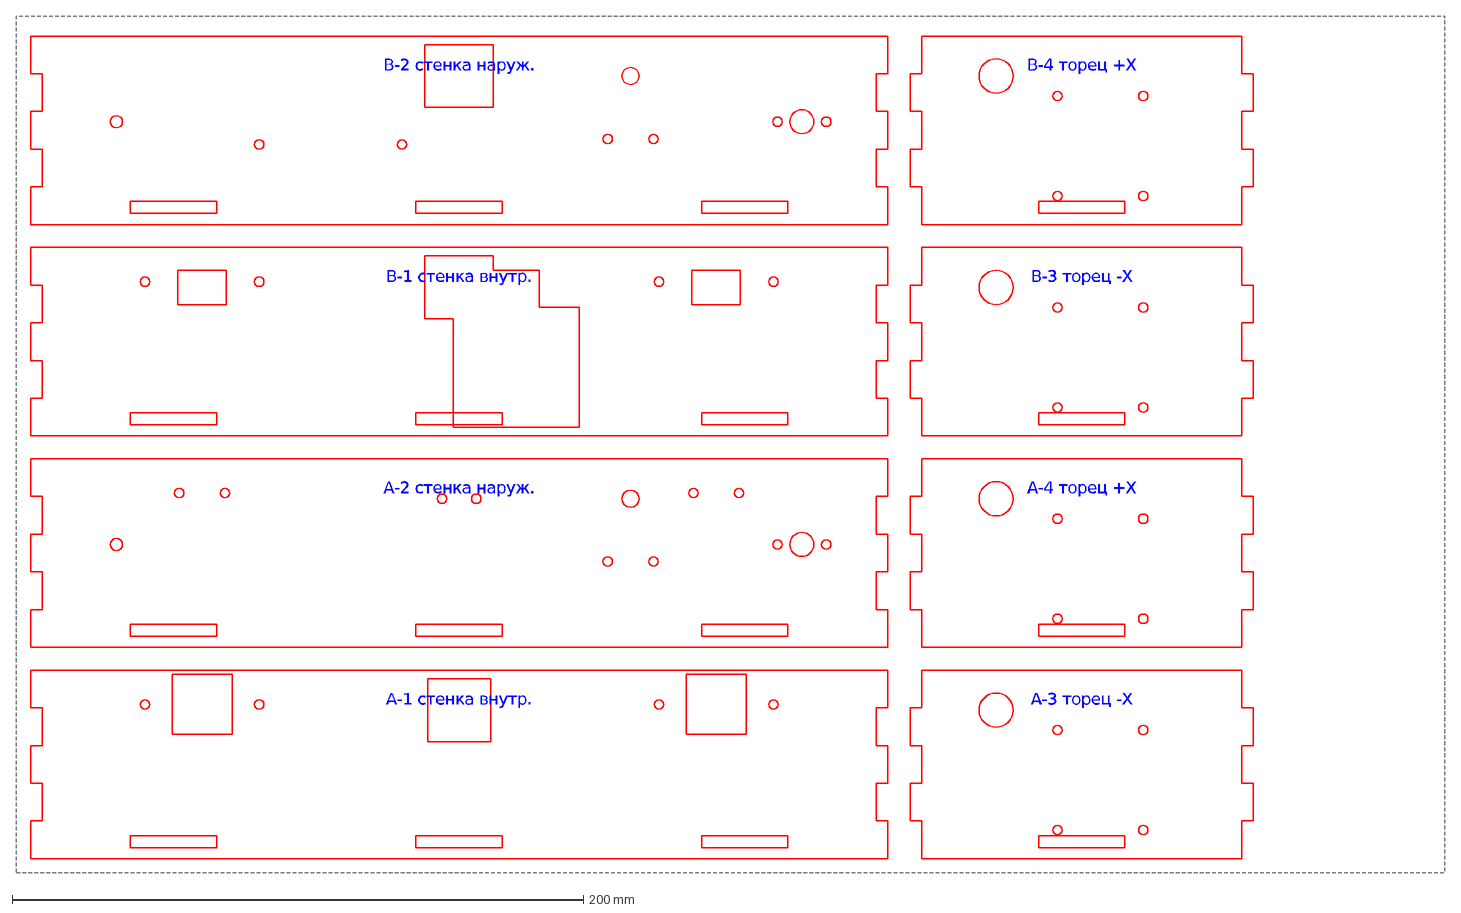
[picture p37: CAD file, 2026-11-08]
cad/dxf/ФОРС1_1к2_корпуса_фанера4_лист1.dxf
A-1 стенка внутр.
A-2 стенка наруж.
B-1 стенка внутр.
B-2 стенка наруж.
A-3 торец -X
A-4 торец +X
B-3 торец -X
B-4 торец +X
