Wexito11/Force-1-Hardato/cad/step/Ролик_ремня_GT2.step

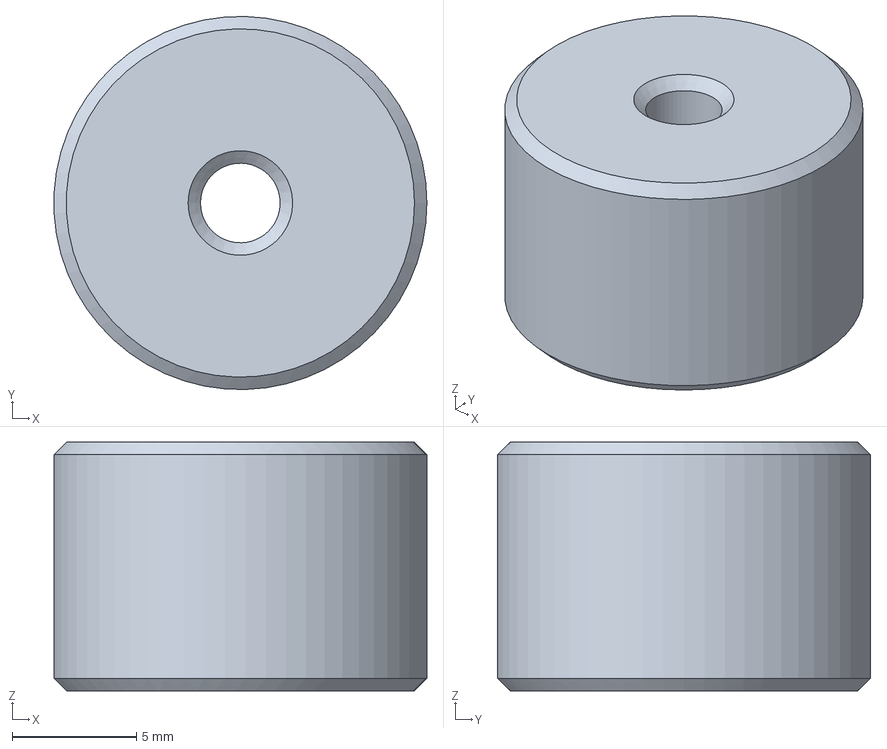
[picture p38: CAD file, 2026-11-08]
cad/step/Ролик_ремня_GT2.step
15.0 x 15.0 x 10.0 mm
