Wexito11/Force-1-Hardato/cad/stl/small/Колодка_ремня.stl

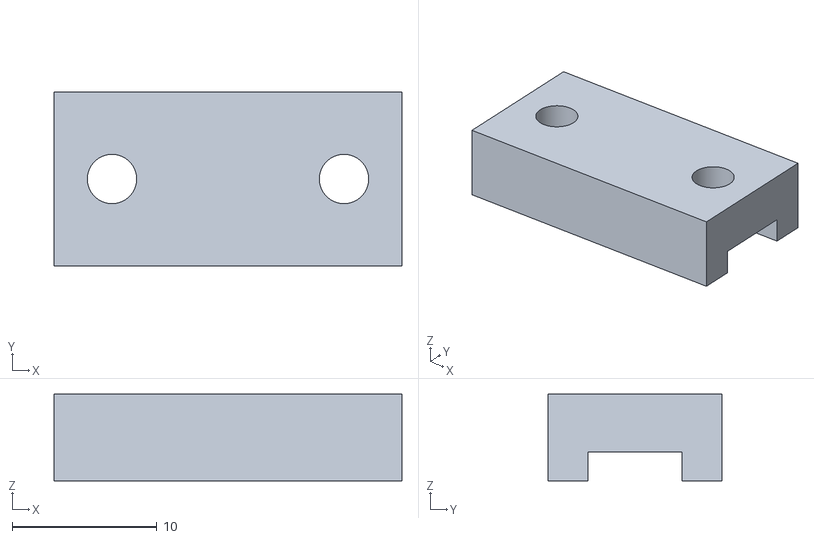
[picture p39: CAD file, 2026-11-08]
cad/stl/small/Колодка_ремня.stl
24.0 x 12.0 x 6.00
