Wexito11/Force-1-Hardato/track/test-rail-1k2/ТР_фанера4_накладки.dxf

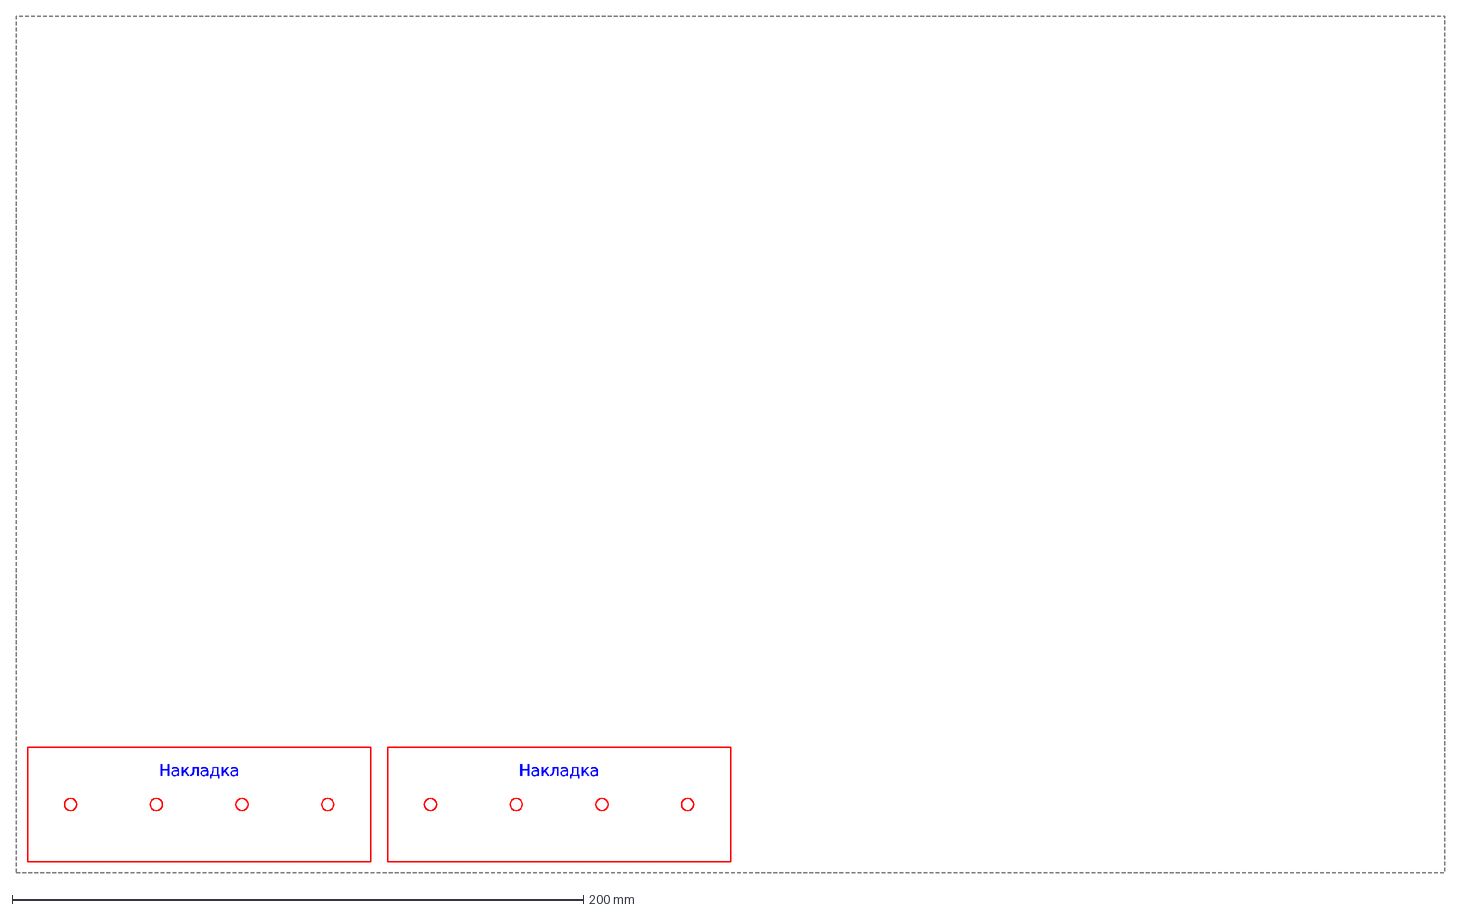
[picture p40: CAD file, 2026-11-08]
track/test-rail-1k2/ТР_фанера4_накладки.dxf
Накладка
