Wexito11/Force-1-Hardato/cad/dxf/ФОРС1_1к2_полозья_фанера6.dxf

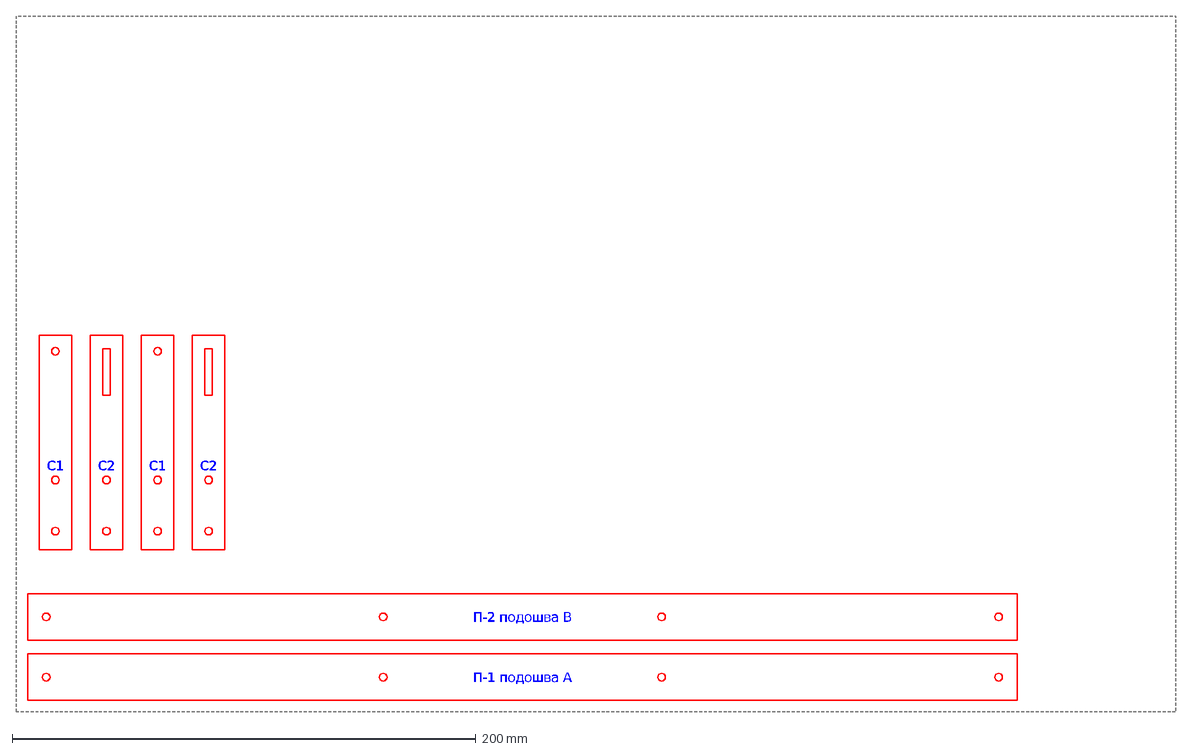
[picture p41: CAD file, 2026-11-08]
cad/dxf/ФОРС1_1к2_полозья_фанера6.dxf
П-1 подошва A
С1
С2
П-2 подошва B
