Wexito11/Force-1-Hardato/cad/step/Вкладыш_телескопа.step

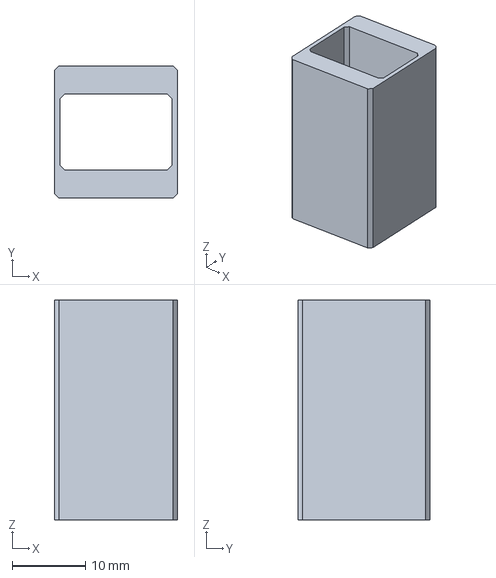
[picture p42: CAD file, 2026-11-08]
cad/step/Вкладыш_телескопа.step
16.8 x 18.0 x 30.0 mm
