Wexito11/Force-1-Hardato/cad/stl/small/Наконечник_звена_Ø6.stl

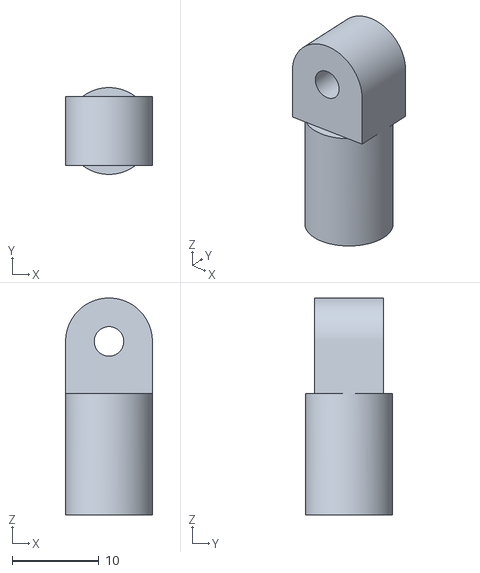
[picture p43: CAD file, 2026-11-08]
cad/stl/small/Наконечник_звена_Ø6.stl
10.0 x 10.0 x 25.0
