Wexito11/Force-1-Hardato/track/test-rail-1k2/ТР_фанера10.dxf

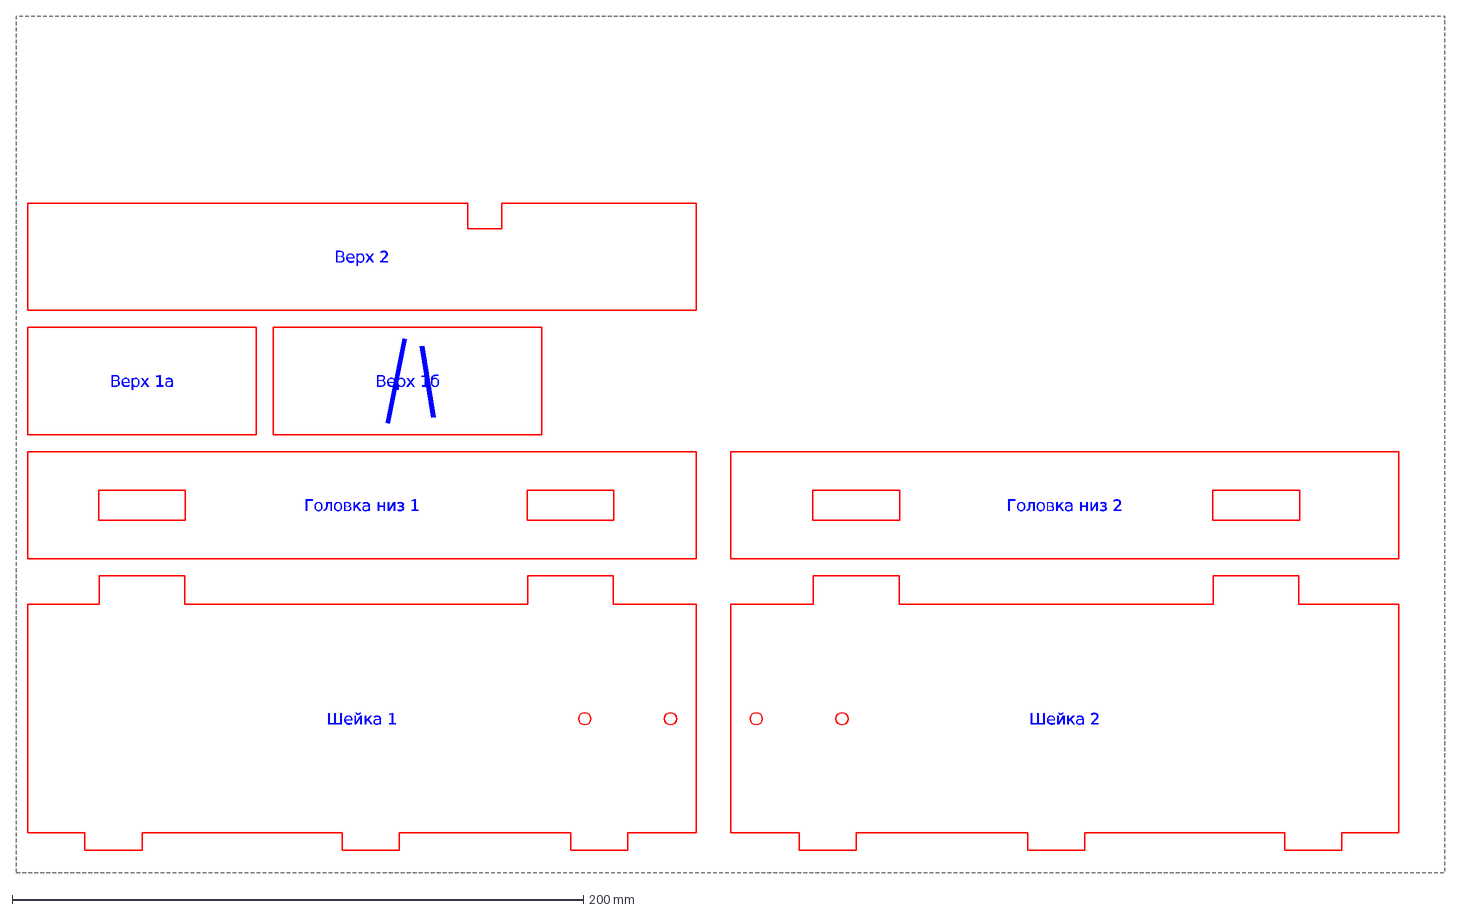
[picture p44: CAD file, 2026-11-08]
track/test-rail-1k2/ТР_фанера10.dxf
Шейка 1
Шейка 2
Головка низ 1
Головка низ 2
Верх 1а
Верх 1б
Верх 2
