Wexito11/Force-1-Hardato/cad/dxf/ФОРС1_1к2_крышки_оргстекло3.dxf

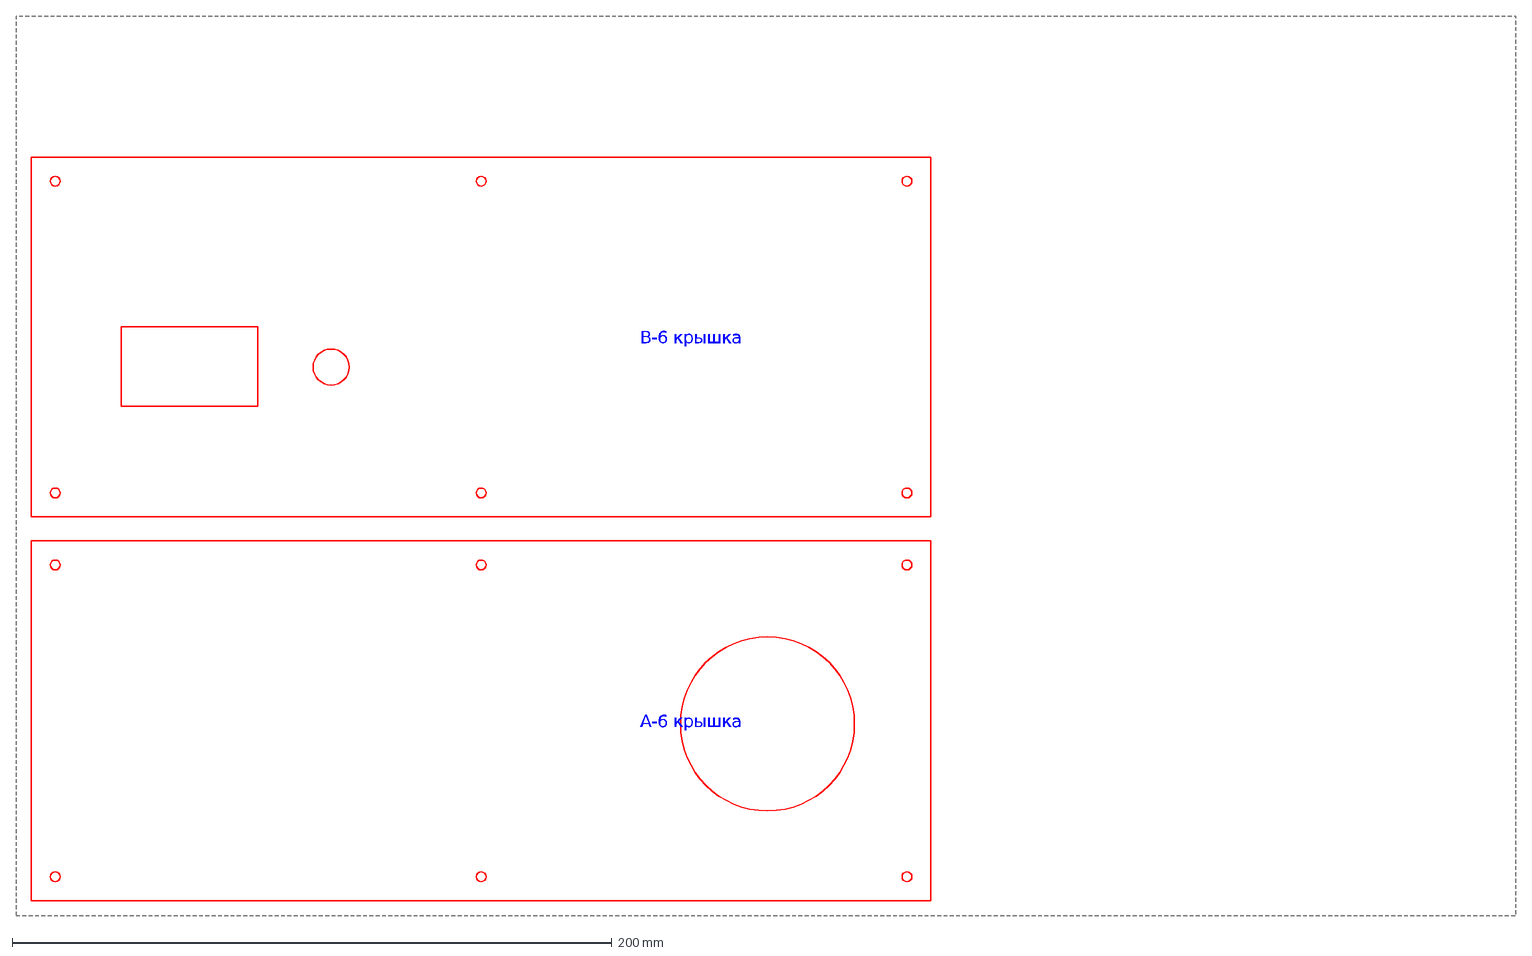
[picture p45: CAD file, 2026-11-08]
cad/dxf/ФОРС1_1к2_крышки_оргстекло3.dxf
A-6 крышка
B-6 крышка
