Wexito11/Force-1-Hardato/cad/stl/small/Площадка_лидара_C1.stl

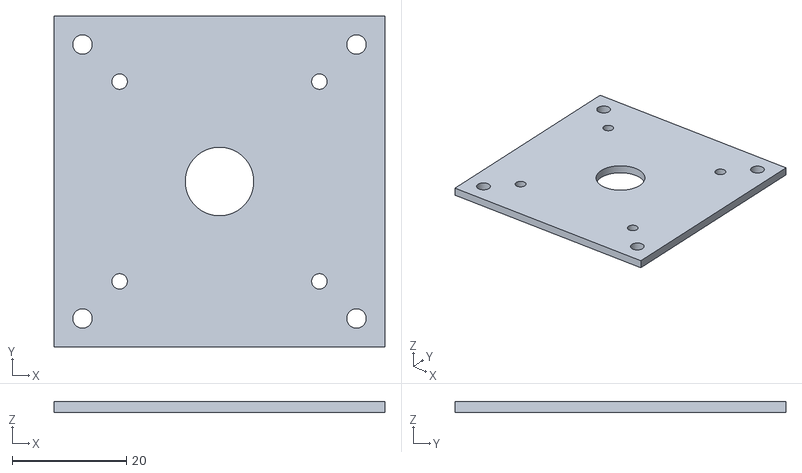
[picture p46: CAD file, 2026-11-08]
cad/stl/small/Площадка_лидара_C1.stl
58.0 x 58.0 x 2.00
