Wexito11/Force-1-Hardato/cad/step/Стойка_HC-SR04.step

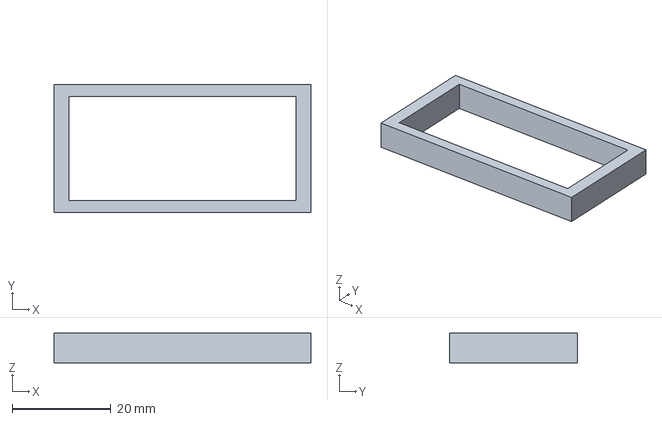
[picture p47: CAD file, 2026-11-08]
cad/step/Стойка_HC-SR04.step
52.0 x 26.0 x 6.00 mm
