Wexito11/Force-1-Hardato/cad/stl/small/Кронштейн_TOF250.stl

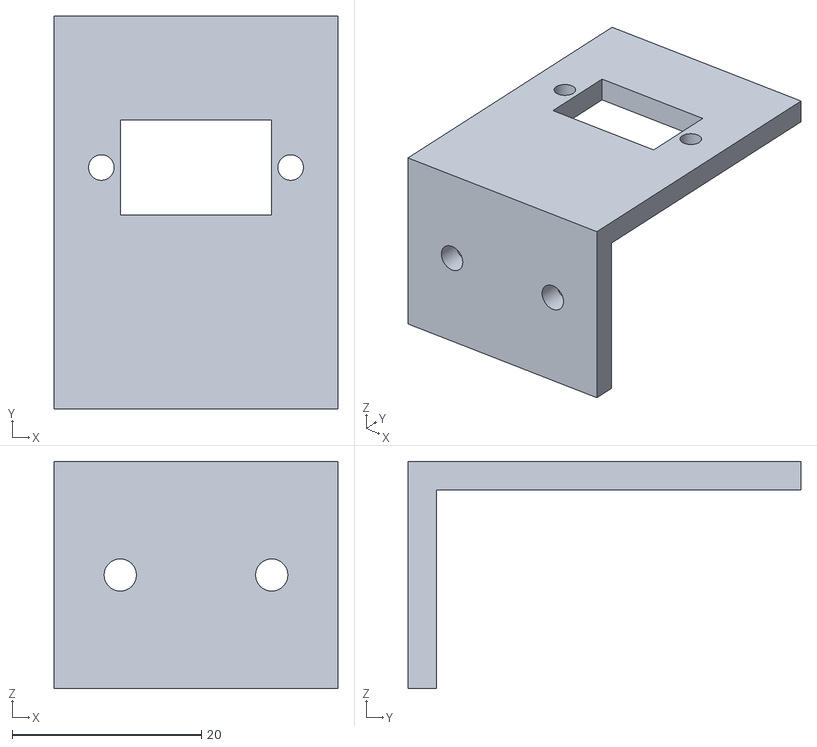
[picture p48: CAD file, 2026-11-08]
cad/stl/small/Кронштейн_TOF250.stl
30.0 x 41.5 x 24.0
