Wexito11/Force-1-Hardato/cad/stl/small/Ролик_ремня_GT2.stl

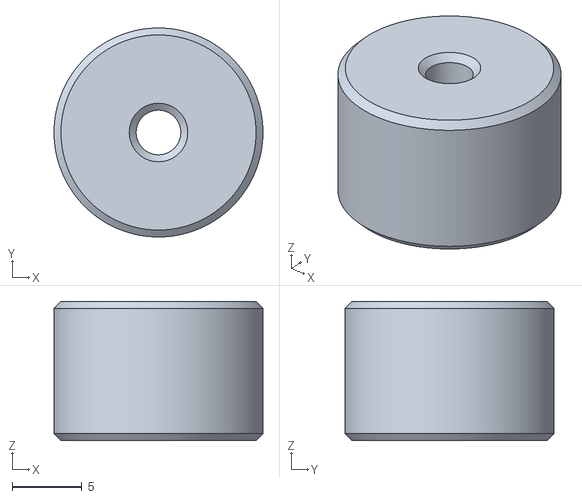
[picture p49: CAD file, 2026-11-08]
cad/stl/small/Ролик_ремня_GT2.stl
15.0 x 15.0 x 10.0
