Wexito11/Force-1-Hardato/cad/step/Форс1_1к2_на_рельсах.step

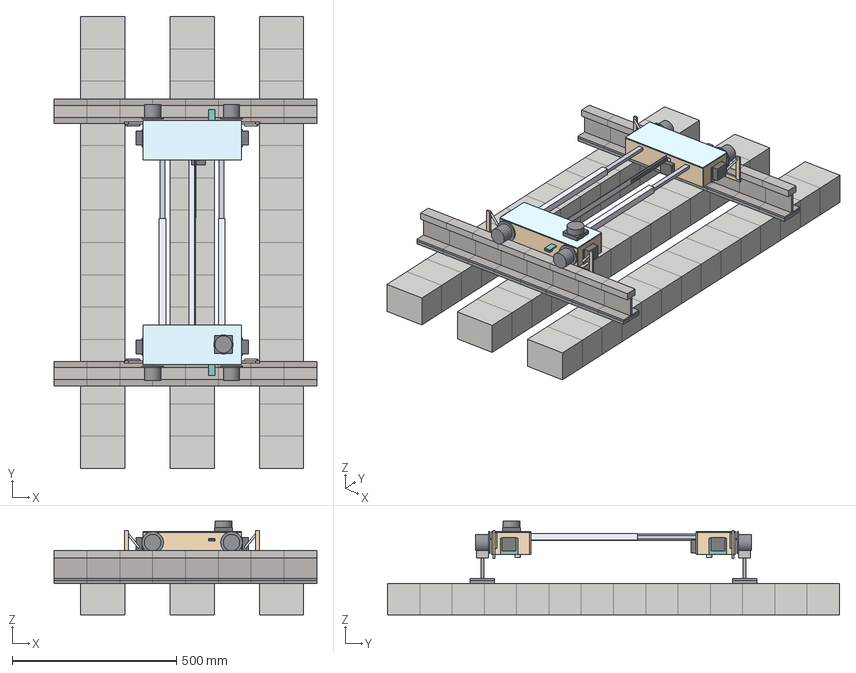
[picture p51: CAD file, 2026-11-08]
cad/step/Форс1_1к2_на_рельсах.step
800.0 x 1375.0 x 285.0 mm
p0
p1
p2
p3
p4
p5
p6
p7
p8
p9
p10
p11
p12
p13
p14
p15
p16
p17
p18
p19
p20
p21
p22
p23
p24
p25
p26
p27
p28
p29
p30
p31
p32
p33
p34
p35
p36
p37
p38
p39
p40
p41
p42
p43
p44
p45
p46
p47
p48
p49
p50
p51
p52
p53
p54
p55
p56
p57
p58
p59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
