Wexito11/Force-1-Hardato/cad/step/Колесо_1к2_холостое_M4.step

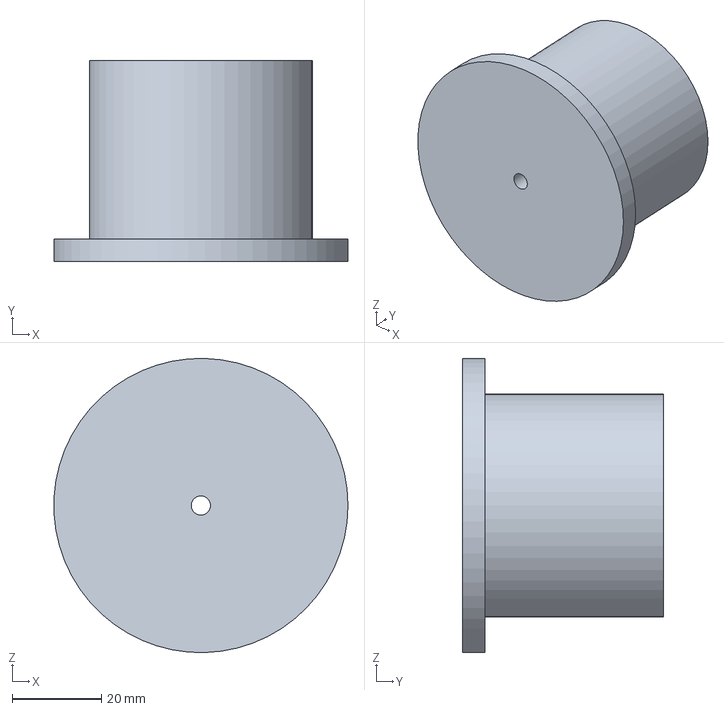
[picture p52: CAD file, 2026-11-08]
cad/step/Колесо_1к2_холостое_M4.step
65.9 x 45.0 x 66.0 mm
