Wexito11/Force-1-Hardato/(list of files, cad)

Other CAD files:
cad/step/Наконечник_звена_Ø6.step
cad/step/Кронштейн_TOF250.step
cad/stl/small/Кронштейн_MG996R_торец.stl
cad/step/Площадка_лидара_C1.step
cad/stl/small/Вкладыш_телескопа.stl
cad/step/Держатель_AS5600.step
cad/step/Колодка_ремня.step
cad/stl/small/Стойка_HC-SR04.stl
cad/step/Колесо_1к2_ведущее_JGA25.step
cad/stl/Колесо_1к2_ведущее_JGA25.stl
cad/stl/Колесо_1к2_холостое_M4.stl
