Wexito11/Force-1-Hardato/electronics/Форс-1_монтажная_схема.pdf

## MPU-9250

# Raspberry Pi 5

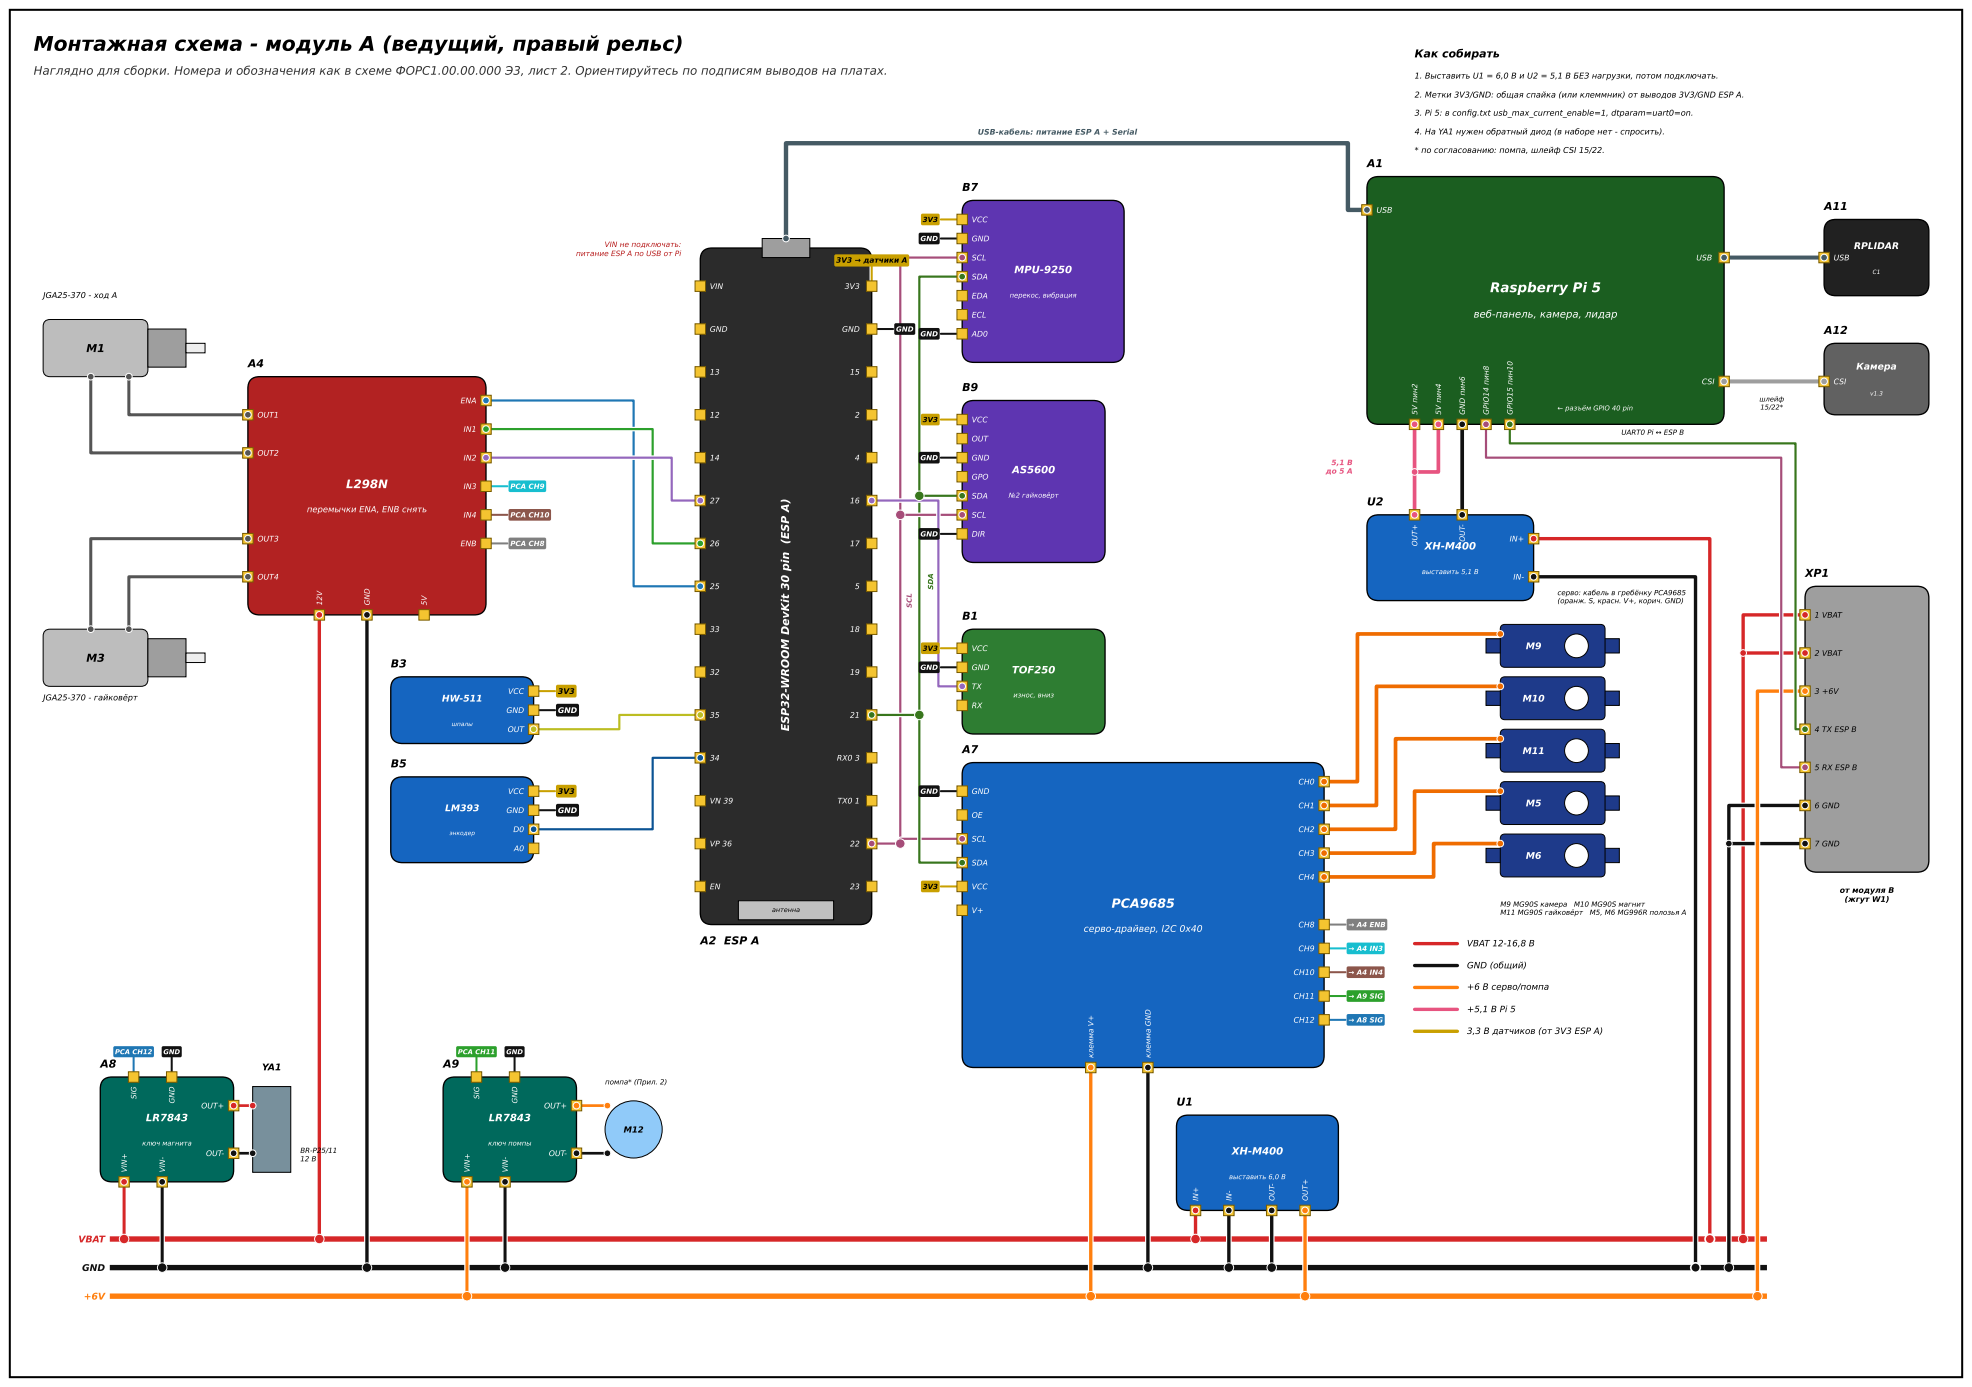
[picture p53: page 1]
шпалы; энкодер; перекос, вибрация; №2 гайковёрт; TOF250; износ, вниз; PCA9685; серво-драйвер, I2C 0x40; ключ магнита; ключ помпы; выставить 6,0 В; выставить 5,1 В; Камера; RPLIDAR; GND; VIN; антенна; OUT1; OUT2; OUT3; OUT4; ENA; ENB; VCC; OUT; SCL; SDA; EDA; ECL; GPO; DIR; клемма V+; клемма GND; OUT+; OUT-; SIG GND; VIN+; VIN-; OUT+ OUT-; USB; CSI; 5V пин2; 5V пин4; GND пин6; GPIO14 пин8; GPIO15 пин10; 1 VBAT; 2 VBAT; 4 TX ESP B; 5 RX ESP B; 6 GND; 7 GND; VBAT; A2 ESP A; JGA25-370 - ход A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

Монтажная схема - модуль A (ведущий, правый рельс)

Наглядно для сборки. Номера и обозначения как в схеме ФОРС1.00.00.000 Э3, лист 2. Ориентируйтесь по подписям выводов на платах.

1. Выставить U1 = 6,0 В и U2 = 5,1 В БЕЗ нагрузки, потом подключать.
2. Метки 3V3/GND: общая спайка (или клеммник) от выводов 3V3/GND ESP A.

3. Pi 5: в config.txt usb_max_current_enable=1, dtparam=uart0=on.
4. На YA1 нужен обратный диод (в наборе нет - спросить).
* по согласованию: помпа, шлейф CSI 15/22.

USB-кабель: питание ESP A + Serial

VIN не подключать:
питание ESP A по USB от Pi

веб-панель, камера, лидар

← разъём GPIO 40 pin

перемычки ENA, ENB снять

ESP32-WROOM DevKit 30 pin (ESP A)

серво: кабель в гребёнку PCA9685
(оранж. S, красн. V+, корич. GND)

3,3 В датчиков (от 3V3 ESP A)

LM393

HW-511

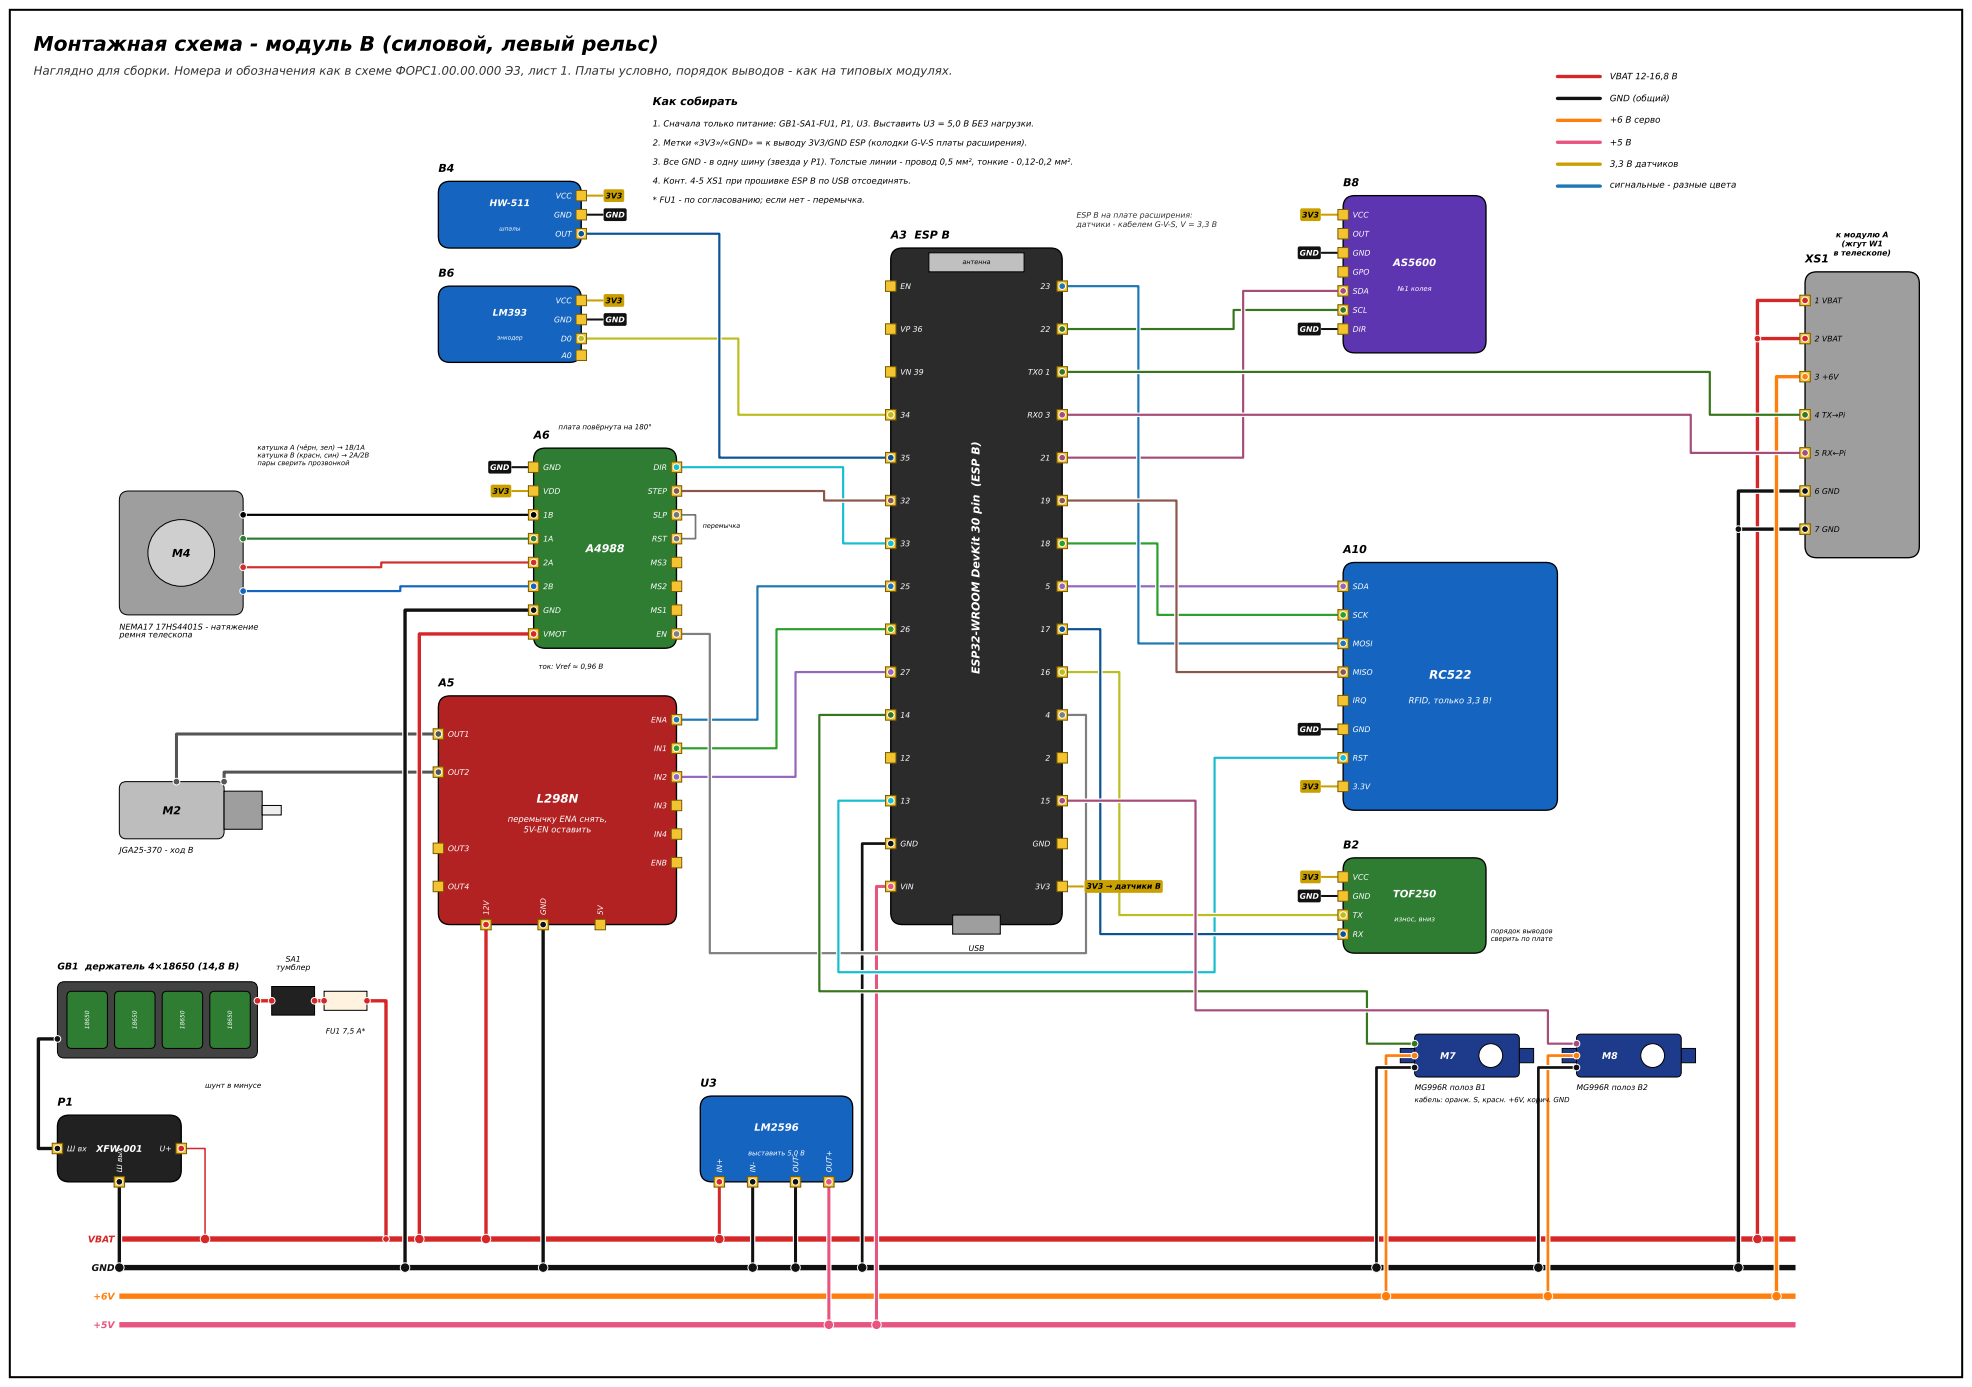
[picture p54: page 2]
XFW-001; выставить 5,0 В; энкодер; шпалы; №1 колея; RFID, только 3,3 В!; TOF250; износ, вниз; GND; VIN; антенна; Ш вых; OUT-; OUT+; OUT1; OUT2; OUT3; OUT4; ENA; ENB; VDD; VMOT; DIR; STEP; SLP; RST; VCC; OUT; GPO; SDA; SCL; SCK; MOSI; MISO; IRQ; 1 VBAT; 2 VBAT; 6 GND; 7 GND; VBAT; A3 ESP B; USB; GB1 держатель 4×18650 (14,8 В); SA1 тумблер; шунт в минусе; JGA25-370 - ход B; перемычка; NEMA17 17HS4401S - натяжение ремня телескопа; ток: Vref ≈ 0,96 В; к модулю A (жгут W1 в телескопе)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

Монтажная схема - модуль B (силовой, левый рельс)

Наглядно для сборки. Номера и обозначения как в схеме ФОРС1.00.00.000 Э3, лист 1. Платы условно, порядок выводов - как на типовых модулях.

1. Сначала только питание: GB1-SA1-FU1, P1, U3. Выставить U3 = 5,0 В БЕЗ нагрузки.
2. Метки «3V3»/«GND» = к выводу 3V3/GND ESP (колодки G-V-S платы расширения).
3. Все GND - в одну шину (звезда у P1). Толстые линии - провод 0,5 мм², тонкие - 0,12-0,2 мм².
4. Конт. 4-5 XS1 при прошивке ESP B по USB отсоединять.
* FU1 - по согласованию; если нет - перемычка.

ESP B на плате расширения:
датчики - кабелем G-V-S, V = 3,3 В

плата повёрнута на 180°

катушка A (чёрн, зел) → 1B/1A
катушка B (красн, син) → 2A/2B
пары сверить прозвонкой

ESP32-WROOM DevKit 30 pin (ESP B)

перемычку ENA снять,
5V-EN оставить

порядок выводов
сверить по плате

кабель: оранж. S, красн. +6V, корич. GND
