Wexito11/Force-1-Hardato/(commit log)

2026-11-02 Начальная структура проекта Форс-1
    README, ТЗ и габариты, концепция и план работ, папки для CAD, электроники, прошивок, демо-пути и учебной версии.
    Claude-Session: https://claude.ai/code/session_01PtSfc7XGpg2StT1UW4aDea
2026-11-02 Контекст проекта и промпты для агентов
    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
2026-11-04 Задачи участника 4: логика, ремонтный модуль, демо-путь
    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
2026-11-08 Сверка перед сдачей, инструкция по сборке, карта проекта; контекст переведён на 1:2
    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
2026-11-08 Экспорт CAD/электроники/тест-рейки, новые рендеры, заготовки прошивок ESP32 A/B и Pi, протокол, сценарий защиты
    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
    [Колесо_1к2_ведущее_JGA25.step, Колесо_1к2_ведущее_JGA25.stl, Колесо_1к2_холостое_M4.step, Колесо_1к2_холостое_M4.stl, ТР_фанера10.dxf, ТР_фанера4_накладки.dxf, ТР_фанера6_основание.dxf, ФОРС1_1к2_корпуса_фанера4_лист1.dxf]
2026-11-08 Лидар перенесён на кронштейн внутренней стенки A; перегенерированы рендеры, DXF, чертежи, STEP; PDF v5
    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
    [ФОРС1_1к2_корпуса_фанера4_лист1.dxf, ФОРС1_1к2_корпуса_фанера4_лист2.dxf, ФОРС1_1к2_крышки_оргстекло3.dxf, ФОРС1_1к2_полозья_фанера6.dxf, Форс1_1к2_на_рельсах.step, Форс1_1к2_укрытие.step]
2026-11-08 Таблица компонентов: правки под 1:2 с сохранением форматирования
    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
    [Форс-1_компоненты.xls]
2026-11-08 Зона укрытия по ГОСТ 9238 (117 мм в 1:2), лидар на крышке A; перегенерированы ГЧ1, ГЧ2, DXF, рендеры, STEP; PDF v6
    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
    [ФОРС1_1к2_корпуса_фанера4_лист1.dxf, ФОРС1_1к2_корпуса_фанера4_лист2.dxf, ФОРС1_1к2_крышки_оргстекло3.dxf, ФОРС1_1к2_полозья_фанера6.dxf, Форс1_1к2_на_рельсах.step, Форс1_1к2_укрытие.step]
2026-11-08 STL мелких деталей, блок-схема с порогами 1:2, письмо организаторам, черновик презентации
    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
    [Вкладыш_телескопа.step, Вкладыш_телескопа.stl, Держатель_AS5600.step, Держатель_AS5600.stl, Колодка_ремня.step, Колодка_ремня.stl, Кронштейн_MG996R_торец.step, Кронштейн_MG996R_торец.stl]
2026-11-09 Пины HC-SR04 модуля A по xls (ETH01), зона укрытия 117/113 в карте и сверке, рендер 5
    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
2026-11-09 ESP A = ETH01 на UART2 во всех текстах, статус 09.11
    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
